nitrobin/OpenBot/body/README.de-DE.md

# OpenBot: Roboterkörper

<p align="center">
  <a href="README.ru-RU.md">Русский</a> |
  <a href="README.md">English</a> |
  <a href="README.zh-CN.md">简体中文</a> |
  <span>Deutsch</span> |
  <a href="README.fr-FR.md">Français</a> |
  <a href="README.es-ES.md">Español</a> |
  <a href="README.ko-KR.md">한국어</a>
</p>

Sie können einen [Ready-to-Run (RTR)](rtr) OpenBot auf Amazon kaufen:
- [RTR-TT](https://buy.openbot.org/rtr-tt)
- [RTR-520](https://buy.openbot.org/rtr-520)

Für größere Bestellungen kontaktieren Sie uns bitte per E-Mail.

## Eigenbau

Sie können einen beliebigen Roboterkörper mit Rädern um einen Mikrocontroller wie den Arduino Nano herum bauen, um ihn mit der OpenBot-Software zu verwenden. Wir haben einen [3D-gedruckten Körper](diy) für einen Roboter mit Rädern entworfen, der auf kostengünstiger, leicht verfügbarer Hobby-Hardware basiert. [OpenBot Lite](lite) ist eine kleinere und vereinfachte Variante der OpenBot DIY-Version, die für Bildungszwecke entwickelt wurde. Selbst wenn Sie ihn nicht bauen möchten, könnten Sie die [Schritt-für-Schritt-Videoanleitungen](lite/#step-by-step-video-guides) hilfreich finden. Wir haben auch einen [3D-gedruckten Körper](rc_truck) für kommerziell erhältliche 1:16 RC-Trucks (wie [diesen](https://www.amazon.de/dp/B00M3J7DJW)) entworfen. Zudem bieten wir Baupläne für ein [Multi-Terrain-Fahrzeug](mtv) an, das als Allzweckplattform für Outdoor-Projekte mit dem OpenBot-Framework dient.

Im Folgenden finden Sie einige Beispiele mit Bauanleitungen und weiteren Details:

<table style="width:100%;border:none;text-align:center">
  <tr>
  <td>  <a href="diy">
    DIY
  </a>
  </td>
  <td>
  <a href="lite">
    Lite
  </a>
  </td>
  <td>
  <a href="rc_truck">
    RC Truck
  </a>
  </td>
  <td>
  <a href="mtv">
    Multi-Terrain Vehicle
  </a>
  </td>
  <td>
  <a href="rtr">
    RTR
  </a>
  </td>
  </tr>
  <tr>
    <td><a href="diy"> DIY </a></td>
    <td><a href="lite"> Lite </a></td>
    <td><a href="rc_truck"> RC Truck </a></td>
    <td><a href="mtv"> Multi-Terrain Vehicle </a></td>
    <td><a href="rtr"> RTR </a></td>
  </tr>
</table>

## Weiter

Flashen Sie die [Arduino-Firmware](../firmware/README.md)
