nitrobin/OpenBot/firmware/README.ru-RU.md

# Прошивка

<p align="center">
  <span>Русский</span> |
  <a href="README.md">English</a> |
  <a href="README.zh-CN.md">简体中文</a> |
  <a href="README.de-DE.md">Deutsch</a> |
  <a href="README.fr-FR.md">Français</a> |
  <a href="README.es-ES.md">Español</a> |
  <a href="README.ko-KR.md">한국어</a>
</p>

Терминология: [глоссарий OpenBot DIY](../GLOSSARY.ru-RU.md).

Микроконтроллер (microcontroller unit, MCU) обеспечивает связь между аппаратной частью робота и смартфоном. Проект содержит [прошивку](openbot/openbot.ino) для Arduino Nano на базе ATmega328P и для отладочных плат ESP32.

## Возможности

Основная задача микроконтроллера — низкоуровневое управление роботом и получение показаний установленных на нём датчиков. По последовательному соединению он принимает команды движения и включения указателей поворота. Команды движения преобразуются в сигналы широтно-импульсной модуляции (ШИМ, PWM) для драйвера двигателей; светодиоды переключаются в соответствии с командами указателей поворота.

Программа также отслеживает вращение колёс, подсчитывая прерывания от оптических датчиков на переднем левом и переднем правом колёсах. Напряжение аккумуляторной батареи вычисляется по измерениям делителя напряжения с фильтрацией скользящим средним и пересчётом масштаба. Дополнительный ультразвуковой дальномер позволяет измерять расстояние до препятствий перед роботом. Результаты измерений передаются в приложение Android по последовательному соединению.

## Выбор аппаратной конфигурации

В начале файла прошивки выберите вариант конструкции робота:

- Самостоятельная сборка с Arduino Nano и драйвером L298N: `OPENBOT DIY`.
- Специализированная печатная плата: `OPENBOT PCB_V1` или `OPENBOT PCB_V2` в зависимости от версии платы.
- Комплект OpenBot с мотор-редукторами TT: `OPENBOT RTR_TT`.
- Переоборудованный радиоуправляемый грузовик: `OPENBOT RC_CAR`.
- Уменьшенный учебный вариант DIY: `OPENBOT LITE`.
- Комплект Ready-to-Run с двигателями серии 520: `OPENBOT RTR_520`.
- Вездеходная платформа Multi-Terrain Vehicle: `OPENBOT MTV`.
- Самостоятельная сборка с ESP32: `OPENBOT DIY_ESP32`.

Например, для варианта DIY на ESP32 строка выбора конфигурации должна выглядеть так:

```cpp
#define OPENBOT DIY_ESP32
```

## Bluetooth

OpenBot может обмениваться данными со смартфоном по Bluetooth. Для этого нужна поддерживаемая плата ESP32, например в конфигурациях `RTR_520`, `MTV` или `DIY_ESP32`.

**Уточнение к исходнику:** английская инструкция указывает `BLUETOOTH 1`, но в [текущей прошивке](openbot/openbot.ino) используется флаг `HAS_BLUETOOTH`. Для включения установите `HAS_BLUETOOTH 1`, для отключения — `HAS_BLUETOOTH 0` в блоке выбранной аппаратной конфигурации.

## Настройка функций

Выберите функции, которые необходимо включить. Отключённые функции не компилируются, что экономит память и ускоряет выполнение программы. Если флаг не определён, функция отключена. Для каждого варианта робота предусмотрены настройки по умолчанию; изменяйте их в соответствии с фактически установленными компонентами.

- Делитель напряжения: `HAS_VOLTAGE_DIVIDER 1` для включения, `0` для отключения. При наличии делителя укажите коэффициент `VOLTAGE_DIVIDER_FACTOR`, рассчитываемый как `(R1+R2)/R2`, минимальное напряжение для привода двигателей `VOLTAGE_MIN`, нижний порог напряжения батареи `VOLTAGE_LOW` и максимальное напряжение батареи `VOLTAGE_MAX`.
- Светодиоды указателей поворота: `HAS_INDICATORS 1`, отключение — `0`.
- Передние и задние датчики частоты вращения: `HAS_SPEED_SENSORS_FRONT 1` и `HAS_SPEED_SENSORS_BACK 1` соответственно, отключение — `0`.
- Ультразвуковой дальномер: `HAS_SONAR 1`, отключение — `0`. Для медианной фильтрации измерений используйте `SONAR_MEDIAN 1`, отключение — `0`.
- Датчик столкновения в бампере: `HAS_BUMPER 1`, отключение — `0`.
- OLED-дисплей: `HAS_OLED 1`, отключение — `0`.
- Передние, задние светодиоды и светодиоды состояния: `HAS_LEDS_FRONT 1`, `HAS_LEDS_BACK 1` и `HAS_LEDS_STATUS 1` соответственно, отключение — `0`.

**Уточнение к исходнику:** для медианного фильтра в английском README указано `USE_MEDIAN`, а в текущем коде используется `SONAR_MEDIAN`.

### Зависимости

Если включены датчики частоты вращения или ультразвуковой дальномер, для Arduino Nano установите библиотеку [PinChangeInterrupt](https://github.com/NicoHood/PinChangeInterrupt). У Nano только два вывода внешних прерываний — `D2` и `D3`, причём `D3` также входит в число шести выводов с поддержкой ШИМ. Кроме того, микроконтроллер имеет три группы прерываний по изменению состояния выводов (pin-change interrupts), охватывающие все выводы Arduino. Библиотека обрабатывает эти групповые прерывания и позволяет использовать отдельные выводы как источники прерываний.

Если включён OLED-дисплей, установите [Adafruit_SSD1306](https://github.com/adafruit/Adafruit_SSD1306) и [Adafruit_GFX Library](https://github.com/adafruit/Adafruit-GFX-Library).

Для установки библиотеки:

1. Откройте менеджер библиотек: `Tools` :arrow_right: `Manage Libraries`.
2. Введите название библиотеки в строку поиска.
3. Выберите последнюю версию и нажмите кнопку установки. Если библиотека уже установлена, менеджер покажет её состояние и доступное обновление.

<p float="left">
  
  
</p>

### Клоны Arduino Nano с преобразователем CH340

Для некоторых клонов Nano может понадобиться драйвер USB–последовательного преобразователя [CH340](http://www.wch.cn/product/CH340.html) с сайта производителя WCH:

- [Windows](http://www.wch.cn/downloads/CH341SER_EXE.html).
- [Linux](http://www.wch.cn/download/CH341SER_LINUX_ZIP.html).
- [macOS](http://www.wch.cn/download/CH341SER_MAC_ZIP.html).

### Отладочная плата ESP32

Чтобы добавить поддержку ESP32 в Arduino IDE:

1. Откройте `File > Preferences`.
   <p align="center">
     Настройки Arduino IDE
   </p>
2. В поле `Additional Board Manager URLs` вставьте `https://dl.espressif.com/dl/package_esp32_index.json` и нажмите `OK`.
   <p align="center">
     Добавление адреса пакета плат ESP32
   </p>

   **Примечание:** если уже добавлен адрес пакета ESP8266, разделите адреса запятой:

   ```text
   https://dl.espressif.com/dl/package_esp32_index.json,
   http://arduino.esp8266.com/stable/package_esp8266com_index.json
   ```

3. Откройте менеджер плат: `Tools > Board > Boards Manager`.
   <p align="center">
     Открытие менеджера плат
   </p>
4. Найдите пакет `ESP32 by Espressif Systems`, выберите версию **2.0.17** и нажмите кнопку установки. Согласно исходной инструкции, версии **3.x.x несовместимы с этой прошивкой**.
   <p align="center">
     Установка пакета ESP32
   </p>
5. После установки пакета Arduino IDE готова к загрузке прошивки в ESP32 вашего OpenBot.
   <p align="center">
     Установленная поддержка ESP32
   </p>
6. Выберите плату `ESP32 Dev Module` в меню `Tools > Board > ESP32 Arduino`. Дополнительные пояснения и способы устранения проблем при загрузке прошивки приведены в [инструкции, на которую ссылается исходный README](https://randomnerdtutorials.com/installing-the-esp32-board-in-arduino-ide-windows-instructions/).
   <p align="center">
     Выбор платы ESP32 Dev Module
   </p>

Если загрузка не проходит, попробуйте снизить скорость передачи (baud rate): в меню `Tools` установите `Upload Speed` в значение `115200` бод.

<p align="center">
  Выбор скорости загрузки прошивки
</p>

## Загрузка прошивки

### Настройки Arduino Nano

- `Tools` :arrow_right: `Board` :arrow_right: `Arduino AVR Boards` :arrow_right: `Arduino Nano`.
- `Tools` :arrow_right: `Processor` :arrow_right: `ATmega328P (Old Bootloader)`.
- `Tools` :arrow_right: `Port` :arrow_right: выберите USB-порт подключённой платы.

:memo: **Примечание:** в исходной инструкции отмечено, что недорогие платы Nano часто используют старый загрузчик (`Old Bootloader`), но встречаются и платы с новым. Если загрузка не удаётся, попробуйте изменить выбор процессора на `ATmega328P`.

### Настройки ESP32

- `Tools` :arrow_right: `Board` :arrow_right: `ESP32 Arduino` :arrow_right: `ESP32 Dev Module`.
- `Tools` :arrow_right: `Port` :arrow_right: выберите USB-порт подключённой платы.

### Запись программы в микроконтроллер

Загрузите прошивку через `Sketch` :arrow_right: `Upload` или нажмите кнопку загрузки со стрелкой вправо.

Загрузка прошивки

### Проверка

После успешной загрузки прошивки проверьте функции робота.

1. Убедитесь, что:
   1. Колёса сняты с робота.
   2. Arduino подключена к компьютеру.
   3. Выбран правильный USB-порт.
2. Откройте монитор последовательного порта: `Tools` :arrow_right: `Serial Monitor`.

#### Отправка команд OpenBot

Введите команду в верхнее поле монитора последовательного порта и нажмите кнопку отправки. Доступны следующие команды, если робот поддерживает соответствующие функции:

- `c<left>,<right>` — управление левой и правой сторонами привода. Значения `<left>` и `<right>` находятся в диапазоне [-255, 255]. `0` останавливает двигатели, `255` задаёт максимальное управление для движения вперёд. Меньшие положительные значения уменьшают коэффициент заполнения ШИМ и скорость; отрицательные изменяют полярность управления и задают движение назад.
- `i<left>,<right>` — управление левым и правым указателями поворота. Значения находятся в диапазоне [0, 1]. `i1,0` включает левый указатель, `i0,1` — правый, `i1,1` — оба. Включённые указатели мигают один раз в секунду. `i0,0` выключает их. Одновременно действует одно заданное состояние.
- `l<front>,<back>` — яркость передних и задних светодиодов. Значения `<front>` и `<back>` находятся в диапазоне [0, 255].
- `s<time_ms>` — интервал между запусками измерения ультразвукового дальномера в миллисекундах; значение по умолчанию — 1000. После измерения передаётся результат. Если истёк срок ожидания эхо-сигнала, передаётся значение `MAX_SONAR_DISTANCE`.
- `w<time_ms>` — интервал передачи данных колёсной одометрии в миллисекундах; по умолчанию — 1000. Вращение колёс отслеживается непрерывно, а частота вращения в об/мин вычисляется как среднее за заданный интервал.
- `v<time_ms>` — интервал передачи измерений напряжения в миллисекундах; по умолчанию — 1000. Напряжение измеряется непрерывно и фильтруется скользящим средним по 10 отсчётам. Команда также вызывает передачу минимального напряжения для привода двигателей (`vmin:<value>`), нижнего порога напряжения батареи (`vlow:<value>`) и максимального напряжения батареи (`vmax:<value>`).
- `h<time_ms>` — время в миллисекундах, после которого робот остановится, если не получено новое сообщение контроля активности (heartbeat); по умолчанию — -1.
- `b<time_ms>` — время в миллисекундах до сброса события срабатывания датчика столкновения; по умолчанию — 750.
- `n<color>,<state>` — управление светодиодом состояния. `<color>` задаёт цвет: `b` — синий, `g` — зелёный, `y` — жёлтый. `<state>` задаёт состояние: `0` — выключен, `1` — включён.
- `f` — запрос типа робота и поддерживаемых функций: измерение напряжения (`v`), указатели поворота (`i`), ультразвуковой дальномер (`s`), датчики столкновения (`b`), колёсная одометрия (`wf`, `wb`), светодиоды (`lf`, `lb`, `ls`) и другие. Пример сообщения для указанного в исходнике варианта `RTR_V1`: `fRTR_V1:v:i:s:b:wf:wb:lf:lb:ls:`.

#### Получение сообщений от OpenBot

Набор сообщений зависит от аппаратной конфигурации.

Монитор последовательного порта

- Сообщения с префиксом `v` содержат напряжение аккумуляторной батареи. При подключённой батарее и включённом питании должно отображаться её напряжение. При отключённой батарее или выключенном питании значение должно быть небольшим.
- Сообщения с префиксом `w` содержат показания датчиков частоты вращения в **об/мин (rpm)**. Каждая прорезь диска энкодера изменяет счётчик на +1 или −1 в зависимости от направления вращения. Для стандартного диска с 20 прорезями приходится 20 отсчётов на оборот колеса.
- Сообщения с префиксом `s` содержат оценку расстояния до препятствия перед ультразвуковым дальномером в сантиметрах.
- Сообщения с префиксом `b` сообщают о столкновениях. Коды `lf` (спереди слева), `rf` (спереди справа), `cf` (спереди по центру), `lb` (сзади слева), `rb` (сзади справа) указывают на сработавший датчик.

**Уточнения к исходнику:** в английском README единицы `rpm` ошибочно названы оборотами в секунду. В функции `send_wheel_reading()` [прошивки](openbot/openbot.ino) используется пересчёт в обороты в минуту. Число импульсов на оборот в текущем коде задаётся параметром `TICKS_PER_REV`, а не упомянутым в английской инструкции `DISK_HOLES`.

#### Порядок проверки

Перед проверкой убедитесь, что колёса сняты. Откройте монитор последовательного порта для отправки команд и просмотра ответов OpenBot. При наличии OLED-дисплея состояние робота также отображается на нём в удобном для чтения виде.

1. Включите питание робота и проверьте напряжение батареи — число после `v`. Сравните показание с измерением мультиметром и при необходимости скорректируйте `VOLTAGE_DIVIDER_FACTOR`.
2. Если установлен ультразвуковой дальномер:
   1. Поднесите руку перед датчиком и перемещайте её ближе и дальше. Показание после `s` должно изменяться соответственно.
   2. По наблюдениям разработчиков, ультразвуковой датчик чувствителен к вибрациям. Для проверки устойчивости показаний во время работы:
      1. Разместите робот так, чтобы перед датчиком было не менее 200 см свободного пространства. Показание должно быть `200` или больше.
      2. Некоторое время наблюдайте за показаниями, затем отправьте `c128,128`.
      3. Если показания существенно изменились, уменьшите передачу вибраций от шасси к датчику, например добавьте силиконовый демпфирующий элемент или измените место крепления.
3. Если установлены датчики частоты вращения:
   1. Обеспечьте достаточно свободного пространства перед ультразвуковым дальномером. Показание после `s` должно превышать `STOP_DISTANCE`; по умолчанию это 10 см.
   2. Отправьте `c128,128`. Двигатели начнут вращаться с уменьшенным управлением — коэффициент заполнения ШИМ около 50 %. Для `RTR_TT` исходная инструкция приводит показания 250–300 об/мин в зависимости от степени заряженности батареи (state of charge, SOC). Для DIY или менее мощной батареи значения могут быть ниже. Убедитесь, что все двигатели вращаются вперёд и показания датчиков положительны.
   3. Попробуйте другие команды. `c-128,-128` задаёт вращение всех двигателей назад с заполнением ШИМ около 50 %. `c255,-255` задаёт вращение левых двигателей вперёд, а правых назад с заполнением 100 %. `c-192,192` задаёт вращение левых двигателей назад, а правых вперёд с заполнением около 75 %.
4. Остановите двигатели командой `c0,0` или, при установленном и включённом ультразвуковом дальномере, поднесите руку перед ним.
5. Если установлены указатели поворота, отправьте `i1,0` и проверьте мигание левого светодиода, затем `i0,1` — правого. Для выключения отправьте `i0,0`.

### Режим без смартфона

До проверки с приложением OpenBot можно проверить робот без смартфона. Установите `NO_PHONE_MODE` в `1`. Робот будет двигаться с обычным для этого режима управлением — коэффициентом заполнения ШИМ около 75 % — и замедляться при обнаружении препятствий ультразвуковым дальномером. При приближении к порогу поворота он начнёт поворачивать в случайную сторону и включит указатель поворота с этой стороны. Если расстояние станет меньше порога, робот будет медленно двигаться назад с включёнными обоими указателями.

**Уточнение к исходнику:** порог поворота в текущей прошивке называется `TURN_DISTANCE` и по умолчанию равен 50 см; в английском README использовано устаревшее имя `TURN_THRESHOLD`.

Питание требуется как силовой части робота, так и Arduino. Arduino можно питать от выхода `5V` драйвера L298N, подключив его к выводу `5V` платы, либо через USB от источника питания, например смартфона.

Перед запуском разработчики рекомендуют снять колёса, подключить Arduino к компьютеру и наблюдать за монитором последовательного порта, как описано в разделе [«Проверка»](#проверка). В этом режиме вывод удобнее для чтения и, как OLED-дисплей, показывает напряжение батареи, частоту вращения левых и правых двигателей и расстояние до препятствия впереди. Перемещайте крупный предмет перед датчиком и наблюдайте за изменением частоты вращения двигателей.

:warning: **Предупреждение из исходной инструкции:** если ультразвуковой дальномер отсутствует или отключён, робот будет непрерывно двигаться вперёд с заполнением ШИМ около 75 % и в итоге столкнётся с препятствием. Даже при установленном датчике столкновения возможны из-за помех в измерениях.

## Требования к другим микроконтроллерам

Можно использовать другой микроконтроллер, обеспечив следующие интерфейсы:

- 1 × преобразователь USB–TTL для последовательной связи со смартфоном.
- 4 × выхода ШИМ для управления двигателями.
- 1 × аналоговый вход для контроля напряжения батареи.
- 2 × цифровых вывода для датчиков частоты вращения.
- 1 × цифровой вывод для ультразвукового дальномера, если он установлен.
- 2 × цифровых вывода для светодиодов указателей поворота, если они установлены.

**Уточнение к исходнику:** в общем перечне выше сохранено исходное требование одного цифрового вывода для дальномера. Однако схема OpenBot DIY с Arduino Nano использует два отдельных вывода — `Trigger` и `Echo`; это видно в [инструкции по сборке](../body/diy/README.ru-RU.md) и в настройках `PIN_TRIGGER` / `PIN_ECHO` [прошивки](openbot/openbot.ino).

## Следующий шаг

Соберите и запустите [приложения для Android](../android/README.ru-RU.md).
