nitrobin/OpenBot/body/diy/README.md

# OpenBot DIY

<p align="center">
  <a href="README.ru-RU.md">Русский</a> |
  <span>English</span> |
  <a href="README.zh-CN.md">简体中文</a> |
  <a href="README.de-DE.md">Deutsch</a> |
  <a href="README.fr-FR.md">Français</a> |
  <a href="README.es-ES.md">Español</a> |
  <a href="README.ko-KR.md">한국어</a>
</p>

We have designed a body for a wheeled robot which relies on low-cost, readily available hobby hardware. You can find instructions for building you own robot below. If you have any further questions or concerns, please feel free to contact us. Happy robot building!

## Chassis

### 3D printing

You will need to print and assemble the following parts in order to build your OpenBot.

#### Robot body

There are several options for the robot body depending on your needs and capabilities of your 3D printer. We encourage you to design and build your own, but here are some options as starting point: 

- [Regular body](cad/regular_body/README.md): This is the standard body we designed; it requires a build plate with least 240mmx150mm.
- [Slim body](cad/slim_body/README.md): Since a lot of common 3D printers have a smaller build volume, we have also designed a smaller version without bumpers which fits on a 220mmx220mm build plate at 45 degrees.
- [Glueable body](cad/glue_body/README.md): For printing on 3D printers with even smaller build volumes, there is also a modular body designed by @sloretz with serveral parts that need to be glued together; it fits on a 150mmx140mm build plate.
- [Blocky body](cad/block_body/README.md): This body designed by @Christos-Ps provides multiple variants with options for extra space inside the shell and a lego-compatible top while maintaining a small footprint that requires only 221mmx150mm for printing.

#### Phone mount

In addition, you will need to print a phone mount to be fixed to robot body.

- phone_mount_bottom ([STL](../phone_mount/phone_mount_bottom.stl), [STEP](../phone_mount/phone_mount_bottom.step))
- phone_mount_top ([STL](../phone_mount/phone_mount_top.stl), [STEP](../phone_mount/phone_mount_top.step))

#### Cleaning

Before you proceed with the build, you may need to clean the 3D print.
<p float="left">
  
   
  
</p>

### Alternatives

If you do not have access to a 3D printer, there are several Arduino robot car kits available which you can use as a starting point. These kits come with a chassis, motors and accessories. We recommend to get a basic kit, since you won't need a lot of the electronics and sensors of the more expensive kits. Here are some options:

- Perseids DIY Robot Smart Car Chassis Kit ([EU](https://www.amazon.de/dp/B07DNXBNHY), [US](https://www.amazon.com/dp/B07DNXBFQN))
- SZDoit 4WD Smart Metal Robot Car Chassis Kit ([US](https://www.amazon.com/dp/B083K4RKBP), [AE](https://www.aliexpress.com/item/33048227237.html))
- Joy-it Robot Car Kit 01 ([EU](https://www.amazon.de/dp/B073ZGJF28))
- Smart Car Kit 4WD Smart Robot Car Chassis Kit ([AE](https://www.aliexpress.com/item/4001238626191.html))

You will also need a phone mount. Here are some options:

- Phone Mount ([EU](https://www.amazon.de/dp/B06XDYJNSR), [US](https://www.amazon.com/dp/B09CY8MC2R))

You can also get creative and build your own OpenBot chassis and phone mount using a material of your choice (e.g. wood, cardboard, styrofoam, etc.). If you do, please post some pictures on the [Slack channel](https://github.com/ob-f/OpenBot#contact) so others can admire your creativity. Here is one example by [@custom-build-robots](https://custom-build-robots.com/roboter/openbot-dein-smartphone-steuert-ein-roboter-auto-chassis-bauen/13636):

<p float="left">
  
  
  
</p>

## Assembly

There are two different options for assembly of the robot, DIY and PCB. The DIY approach relies on the popular L298N motor driver and is recommended for hobbyists with some electronics experience. It requires a fair amount of wiring, especially if all the sensors and LEDs are installed. However, all components are readily available in most contries and especially for single builds or just to try out the project, the DIY option is recommended. In order to reduce the wiring and make assembly easier, we have also developed a [custom PCB](pcb). This is recommended if you desire a cleaner build or want to build multiple OpenBots.

### Bill of materials

Our robot body relies on readily available hobby electronics. We provide links for Germany (EU) and the United States (US) with fast shipping. If you have the patience to wait a bit longer, you can also get the components a lot cheaper from AliExpress (AE). You will need the following components.

#### Required components

- 1x Arduino Nano ([EU](https://www.amazon.de/dp/B01MS7DUEM), [US](https://www.amazon.com/dp/B00NLAMS9C), [AE](https://www.aliexpress.com/item/32866959979.html))
- 4x TT motors with tires ([EU](https://www.conrad.de/de/p/joy-it-com-motor01-getriebemotor-gelb-schwarz-passend-fuer-einplatinen-computer-arduino-banana-pi-cubieboard-raspbe-1573543.html), [US](https://www.amazon.com/dp/B081YQM55P), [AE](https://www.aliexpress.com/item/4000126948489.html))
- 3x 18650 battery ([EU](https://www.conrad.de/de/p/conrad-energy-18650-usb-spezial-akku-18650-li-ion-3-7-v-1400-mah-1525536.html), [US](https://www.amazon.com/dp/B083K4XSKG), [AE](https://www.aliexpress.com/item/32352434845.html))
- 1x 18650 battery holder([EU](https://www.amazon.de/dp/B075V25QJ9), [US](https://www.amazon.com/dp/B07DWQYD7H), [AE](https://www.aliexpress.com/item/33037738446.html))
- 1x USB OTG cable ([EU](https://www.amazon.de/gp/product/B075M4CQHZ) ,[US](https://www.amazon.com/dp/B07LBHKTMM), [AE](https://www.aliexpress.com/item/10000330515850.html))
- 1x spring or rubber band ([EU](https://www.amazon.de/gp/product/B01N30EAZO/), [US](https://www.amazon.com/dp/B008RFVWU2), [AE](https://www.aliexpress.com/item/33043769059.html))
- 16x M3x25 screw ([EU](https://www.amazon.de/dp/B07KFL3SSV), [US](https://www.amazon.com/dp/B07WJL3P3X), [AE](https://www.aliexpress.com/item/4000173341865.html))
- 16x M3 nut ([EU](https://www.amazon.de/dp/B07JMF3KMD), [US](https://www.amazon.com/dp/B071NLDW56), [AE](https://www.aliexpress.com/item/32977174437.html))
- 6x M3x5 screw ([EU](https://www.amazon.de/dp/B01HBRG3W8), [US](https://www.amazon.com/dp/B07MBHMLL2), [AE](https://www.aliexpress.com/item/32892594230.html))
- Dupont cables ([EU](https://www.amazon.de/dp/B07KYHBVR7), [US](https://www.amazon.com/dp/B07GD2BWPY), [AE](https://www.aliexpress.com/item/4000766001685.html))

#### Optional components

- 2 x Speed Sensor ([EU](https://www.conrad.de/de/p/joy-it-sen-speed-erweiterungsmodul-passend-fuer-einplatinen-computer-arduino-banana-pi-cubieboard-raspberry-pi-pc-1646891.html), [US](https://www.amazon.com/dp/B081W2TY6Q), [AE](https://www.aliexpress.com/i/32850602744.html))
- 1x Ultrasonic Sensor ([EU](https://www.amazon.de/dp/B00LSJWRXU), [US](https://www.amazon.com/dp/B0852V181G/), [AE](https://www.aliexpress.com/item/32713522570.html))
- 1x On/Off Switch ([EU](https://www.amazon.de/dp/B07QB22J62), [US](https://www.amazon.com/dp/B01N2U8PK0), [AE](https://www.aliexpress.com/item/1000005699023.html))
- 2x Orange LED 5mm ([EU](https://www.amazon.de/gp/product/B01NCL0UTQ), [US](https://www.amazon.com/dp/B077XD7MVB), [AE](https://www.aliexpress.com/item/4000329069943.html))
- 1x OLED display ([EU](https://www.amazon.de/dp/B079H2C7WH), [US](https://www.amazon.com/dp/B085NHM5TC), [AE](https://www.aliexpress.com/item/4001268387467.html))

#### DIY components (Option 1)

- 1x L298N Motor Driver ([EU](https://www.conrad.de/de/p/joy-it-motormodul-2-u-4-phasen-6-bis-12v-1573541.html), [US](https://www.amazon.com/dp/B085XSLKFQ), [AE](https://www.aliexpress.com/item/32994608743.html))
- (Optional) Resistors (2x 150<span>&#8486;</span> for the LEDs and a 20 k<span>&#8486;</span> and 10k<span>&#8486;</span> for the voltage divider)
- (Combo) 4x TT motors & tires + 2x L298N + dupont cables ([US](https://www.amazon.com/dp/B07ZT619TD))
- (Combo) 4x TT motors & tires + wires + screws ([US](https://www.amazon.com/dp/B07DRGTCTP))

#### PCB components (Option 2)

- 1x [Custom PCB](pcb)
- 5x Micro JST PH 2.0 cable ([EU](https://www.amazon.de/gp/product/B07449V33P), [US](https://www.amazon.com/dp/B09JZC28DP), [AE](https://www.aliexpress.com/item/32963304134.html))

### Build instructions

**Tip:** Click on the images to open them in full resolution in a new tab.

#### Option 1: DIY

<p float="left">
  
   
</p>

**Tip:** To make all the wiring easier you can build a small power distributor for the 5V and GND connections by soldering a 6x2 male header to a perfboard. Then connect the power distributor with the 5V / GND of the motor driver.

1. Solder wires to the motors and add the encoder disks to the two front motors if you intend to use the speed sensors.
    <p float="left">
      
       
    </p>
2. Insert the positive and negative leads of the two left motors into OUT1 (+) and OUT2 (-) of the L298N board. Insert the positive and negative leads of the two right motors into OUT4 (+) and OUT3 (-) of the L298N board.
3. Mount the motors with eight M3x25 screws and nuts.
    <p float="left">
      
       
      
    </p>
4. Mount the L298N with four M3x5 screws
5. (Optional) Install the ultrasonic sensor and replace the angled connector with a straigt one (or carefully bend the pins).
    <p float="left">
      
       
      
    </p>
6. (Optional) Install the orange LEDs for the indicator signals.
    <p float="left">
      
       
      
    </p>
7. Mount the bottom of the phone mount to the top plate using two M3x25 screws and nuts.
    <p float="left">
      
       
      
    </p>
8. Insert the top of the phone mount and install the spring or rubber band.
    <p float="left">
      
       
    </p>
9. Replace the angled connector with a straigt one (or carefully bend the pins) and then mount the speed sensors with one M3x5 screw each.
    <p float="left">
      
       
      
    </p>
10. Install the battery case (e.g. velcro).
    <p float="left">
      
       
      
    </p>
11. (Optional) Insert the on/off switch put it in the current path.
    1. Push the switch into the appropriate opening until you hear a click.
    2. Solder the red wires (12V) of the battery case and the power cable each to one of the pins of the switch. Connect the black wires (GND), and cover the connection with some heatshrink.
    3. Fix the cables with some tape.
    <p float="left">
      
       
      
    </p>
12. (Optional) Attach the OLED display.
13. Connect the PWM inputs of the L298N to pins D5, D6, D9 and D10 of the Arduino.
14. Connect the speed sensors and ultrasonic sensor to 5V and GND.
15. Connect pin D0 of the speed sensors to pins D2 (left) and D3 (right) of the Arduino.
16. Connect pins Echo and Trigger of the ultrasonic sensor to pins D11 and D12 of the Arduino respectively.
17. (Optional) Connect the LEDs to pins D4 (left) and D7 (right) of the Arduino and GND. We recommend to add a 150 Ohm resistor in series to limit the current draw.
18. (Optional) Connect the voltage divider to pin A7 of the Arduino. It is used to measure the battery voltage.
19. (Optional) Connect the OLED display (SSD1306 chip) via the I2C bus to the Arduino Nano
    1. Connect the VIN and GND pins of the display to 5V and GND.
    2. Connect the SCL pin of the display to the A5 pin.
    3. Connect the SDA pin of the display to the A4 pin.
20. Connect the power cables to +12V and GND of the L298N.
21. Connect the USB cable to the Arduino and route it through the top cover.
22. Insert six M3 nuts into the bottom plate and mount the top cover with six M3x25 screws.
23. Install the wheels.

#### Option 2: Custom PCB

1. Solder wires with Micro JST PH 2.0 connectors to the motors and add the encoder disks to the two front motors if you intend to use the speed sensors.
    <p float="left">
      
       
    </p>
2. Mount the motors with eight M3x25 screws and nuts.
    <p float="left">
      
       
      
    </p>
3. Connect the left two motors to M3 and M4 and the right two motors to M1 and M2.
    <p float="left">
      
    </p>
4. Mount the PCB with four M3x5 screws and the motors with eight M3x25 screws and nuts.
    <p float="left">
      
      
    </p>
5. Follow steps 5-12 from the DIY option.
6. Connect the ultrasonic sensor (VCC/+, Trig, Echo, GND/-) to the 4-pin header labeled *SONAR* on the PCB.
    <p float="left">
      
    </p>
7. Connect the left and right indicator signals (orange LEDs) to the 2-pin headers labeled *SIGNAL_L* and *SIGNAL_R* on the PCB. The longer leg is + and the shorter one -.
8. Connect the left and right speed sensors (VCC/+, GND/-, D0) to the 3-pin headers labeled *SPEED_L* and *SPEED_R*.
9. (Optional) Connect the OLED display (SSD1306 chip) to the IO2 header on the PCB.
    1. Connect the VIN and GND pins of the display to 5V and GND.
    2. Connect the SCL pin of the display to the A5 pin.
    3. Connect the SDA pin of the display to the A4 pin.
10. Connect the power cables to Vin (Micro JST PH 2.0 connector) of the PCB.
11. Follow steps 21-23 from the DIY option.

## Next

Flash the [Arduino Firmware](../../firmware/README.md)
