nitrobin/OpenBot/body/diy/fritzing/README.ru-RU.md

# Схема OpenBot DIY для Arduino Nano в Fritzing

Открой [openbot-diy-nano.fzz](openbot-diy-nano.fzz) в Fritzing и выбери вкладку **Schematic**. В файле находятся отдельные редактируемые компоненты, контакты и провода. Все необходимые определения компонентов и SVG включены в `.fzz`; скачивать библиотеку модулей отдельно не требуется.

Для вида с изображениями плат открой [отдельный файл Breadboard для Nano](openbot-diy-nano-breadboard.fzz). [Превью и пояснения](README.breadboard.ru-RU.md) показывают расположение контактов, USB-разъёма и клемм.

[Новая схема отдельного распределителя питания](README.power-hub.ru-RU.md) позволяет подключать батарейный блок и выключатель съёмными двухконтактными разъёмами.

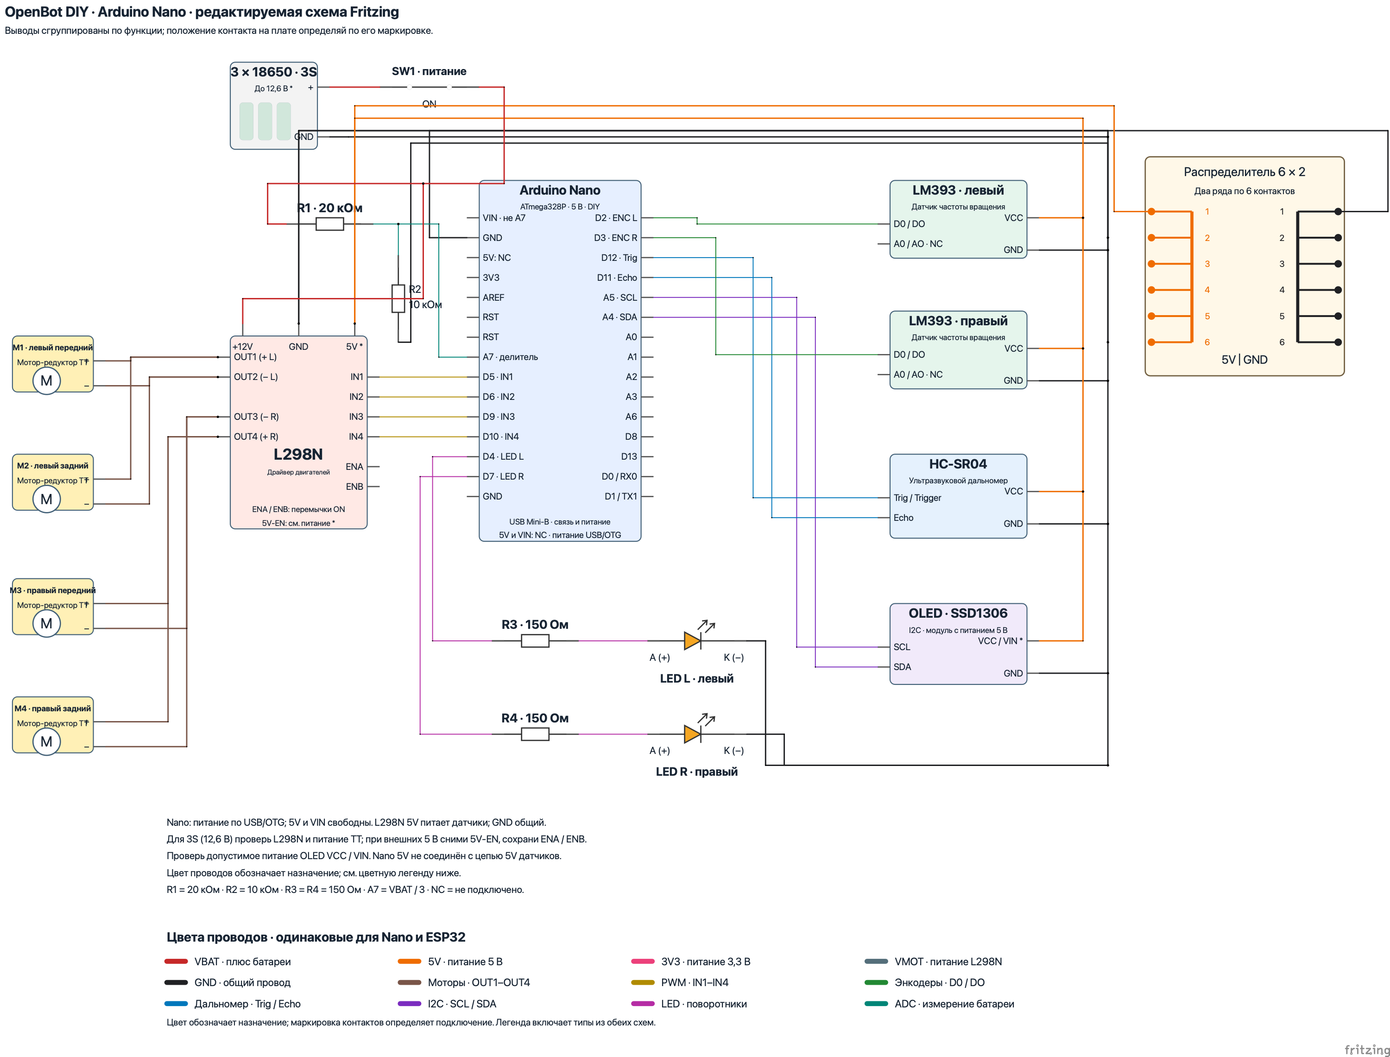
[picture p1: body/diy/fritzing/openbot-diy-nano.png]
Схема OpenBot DIY для Arduino Nano с подписями контактов и номиналами резисторов


Превью PNG экспортировано из Fritzing 1.0.8. На картинку можно нажать, чтобы рассмотреть подписи в полном размере.

Цвета проводов различаются по назначению и совпадают со схемой ESP32. Внизу рисунка есть цветная легенда; [таблица цветов](WIRE-COLORS.ru-RU.md) поясняет все типы цепей.

Схема перерисована по [исходному изображению](../../../docs/images/wiring_diagram.png), [инструкции DIY](../README.ru-RU.md) и блоку `OPENBOT == DIY` в [прошивке](../../../firmware/openbot/openbot.ino). Подписаны оба конца соединений, полярность светодиодов и номиналы резисторов. Положение выводов сгруппировано по функции, чтобы провода можно было проследить. При монтаже находи контакт на своей плате **по маркировке**, а не по его положению в этом рисунке. Во вкладке Breadboard используется тот же порядок выводов. Посадочные места и разводка PCB в этом файле не предусмотрены.

| Arduino Nano | Другой конец соединения |
| --- | --- |
| `D5` | L298N `IN1` |
| `D6` | L298N `IN2` |
| `D9` | L298N `IN3` |
| `D10` | L298N `IN4` |
| `D2` | Левый датчик частоты вращения LM393 `D0` / `DO` |
| `D3` | Правый датчик частоты вращения LM393 `D0` / `DO` |
| `D12` | Ультразвуковой дальномер HC-SR04 `Trig` / `Trigger` |
| `D11` | Ультразвуковой дальномер HC-SR04 `Echo` |
| `A5` | OLED-дисплей SSD1306 `SCL` |
| `A4` | OLED-дисплей SSD1306 `SDA` |
| `D4` | R3 **150 Ом** → анод `A` левого светодиода; катод `K` → `GND` |
| `D7` | R4 **150 Ом** → анод `A` правого светодиода; катод `K` → `GND` |
| `A7` | Средняя точка делителя R1 **20 кОм** / R2 **10 кОм** |
| `5V` | Свободен (`NC`); Arduino Nano получает питание через USB |
| `VIN` | Свободен (`NC`) |
| `GND` | Общий провод (`GND`) всех плат и минус аккумуляторной батареи |

R1 включён между плюсом батареи **после SW1** и `A7`. R2 включён между `A7` и `GND`. Это измерительная цепь: `A7 = VBAT / 3`, то есть 4,2 В при напряжении батареи 12,6 В. Контакт питания Nano `VIN` оставлен свободным; он не является входом этого делителя.

**Питание Arduino Nano:** телефон → USB OTG → USB Mini-B Nano. USB обеспечивает питание и последовательную связь; при проверке от ПК Nano также получает питание через USB. Возможность питания Nano от USB описана в [документации Arduino](https://docs.arduino.cc/resources/datasheets/A000005-datasheet.pdf); USB предусмотрен в шаге 21 [инструкции OpenBot DIY](../README.md#option-1-diy). `A7` — аналоговый вход измерения напряжения, питание через него не подаётся. Контакты `5V` и `VIN` Nano внешними проводами не подключены. `GND` Nano соединён с `GND` L298N и датчиков. Обозначение `NC` у `5V` означает отсутствие внешнего провода; при питании по USB на внутренней шине Nano всё равно есть питание.

Два левых мотор-редуктора подключены параллельно: положительные провода к L298N `OUT1`, отрицательные к `OUT2`. Два правых подключены параллельно: положительные к `OUT4`, отрицательные к `OUT3`, как в инструкции DIY. `A0` / `AO` датчиков частоты вращения не подключены. Если у твоего датчика только три контакта, используй `VCC`, `GND` и `D0` / `DO`.

## Технические уточнения

Назначение контактов управления взято из блока `DIY` прошивки: `PIN_PWM_L1=5`, `PIN_PWM_L2=6`, `PIN_PWM_R1=9`, `PIN_PWM_R2=10`, `PIN_LED_LI=4`, `PIN_LED_RI=7`. На новой схеме показаны четыре линии `IN1`–`IN4`; `ENA` и `ENB` имеют установленные перемычки. Они отличаются от перемычки регулятора питания **5V-EN**.

Цепь питания `5V` исходного изображения соединяет L298N, датчики и OLED-дисплей; `5V` Nano к этой цепи не подключён. Это не подтверждает пригодность встроенного регулятора конкретной платы L298N для полностью заряженной батареи 3S (12,6 В) или пригодность твоих мотор-редукторов TT для такого питания. Для внешнего стабилизированного источника 5 В на стандартном модуле L298N следует отключить **5V-EN**, оставив перемычки **ENA/ENB**. Перед монтажом проверь документацию своей платы. Контакт `5V` Nano оставлен свободным и при таком питании датчиков.

**Исправление перерисовки:** в ранних файлах Fritzing был ошибочно добавлен провод между `5V` Nano и цепью `5V` L298N/датчиков. Этот провод удалён из обоих вариантов Nano и обоих видов, согласно [исходной картинке](../../../docs/images/wiring_diagram.png). Все остальные соединения сохранены.

В исходной текстовой инструкции питание OLED названо `VIN`, а на изображении — `VCC`. На новой схеме показаны оба варианта маркировки; подключение к 5 В допустимо только для OLED-модуля, рассчитанного на 5 В. Это не означает, что `VIN` и `VCC` взаимозаменяемы на любой плате.

В текущей прошивке `DIY` дополнительные функции изначально выключены: `HAS_VOLTAGE_DIVIDER`, `HAS_INDICATORS`, `HAS_SONAR`, `HAS_SPEED_SENSORS_FRONT`, `HAS_OLED` равны `0`. После установки нужных компонентов включи соответствующие функции и загрузи обновлённую прошивку. Сам файл Fritzing прошивку не меняет.

## Файлы и проверка

[openbot-diy-nano.fzz](openbot-diy-nano.fzz) — переносимый файл для открытия и редактирования в Fritzing. Все определения компонентов и их графика находятся внутри этого файла. Сохраняй правки непосредственно в `.fzz`.

[validate_topology.py](validate_topology.py) сравнивает соединения четырёх схем с коммитом `12c12e5`, включая свободные контакты, номиналы и внутренние шины. Для Nano эталон содержит явное исправление ранней перерисовки: `5V` Nano должен быть свободен, а общий `GND` сохранён. Остальные цепи сравниваются без изменений. [Отчёт проверки](topology-validation.json) содержит это исправление, результат и контрольные суммы файлов.

Для проверки из корня репозитория:

```sh
python3 body/diy/fritzing/validate_topology.py
```

Проверка читает `.fzz` и обновляет отчёт. Для сравнения нужна история Git с коммитом `12c12e5`.

Created with [Fritzing](https://fritzing.org/). Принципиальная схема и её собственная графика распространяются по [CC BY-SA 3.0](https://creativecommons.org/licenses/by-sa/3.0/); основаны на документации OpenBot. Скрипт проверки распространяется на условиях лицензии OpenBot, указанной в корне репозитория.

Распределитель питания 6 × 2 добавлен согласно инструкции DIY; его ряды `5V` и `GND` изолированы друг от друга. [Пояснения к колодке и источники графики Breadboard](README.breadboard.ru-RU.md).
