nitrobin/OpenBot/body/diy/pcb/README.ru-RU.md

# Специализированная печатная плата

<p align="center">
  <span>Русский</span> |
  <a href="README.md">English</a> |
  <a href="README.zh-CN.md">简体中文</a> |
  <a href="README.de-DE.md">Deutsch</a> |
  <a href="README.fr-FR.md">Français</a> |
  <a href="README.es-ES.md">Español</a> |
  <a href="README.ko-KR.md">한국어</a>
</p>

Терминология: [глоссарий OpenBot DIY](../../../GLOSSARY.ru-RU.md).

Специализированная печатная плата (custom PCB) служит платой-носителем (carrier board) для Arduino Nano. На ней размещены современные драйверы двигателей, делитель напряжения и резисторы светодиодов. Arduino устанавливается в контактную колодку, а датчики и светодиоды подключаются проводами Dupont к соответствующим разъёмам.

Вид печатной платы версии 2 сверху
Трёхмерный вид печатной платы версии 2

Последняя представленная здесь плата — [версия 2](v2). По сравнению с [версией 1](v1) внесены следующие изменения:

- Правый датчик частоты вращения подключён к выводу `D3`, чтобы использовать внешнее прерывание.
- Добавлен светодиод индикации питания от основной аккумуляторной батареи.
- Некоторые компоненты заменены более доступными аналогами.
- Номиналы резисторов делителя напряжения изменены на 20 кОм / 10 кОм для повышения точности.
- Разъёмы двигателей заменены прямыми, с вертикальным расположением контактов, для более удобного доступа.

Если вы уже заказали [версию 1](v1) платы ([вид сверху](../../../docs/images/pcb_2d_v1.png), [трёхмерный вид](../../../docs/images/pcb_3d_v1.png)), она также будет работать. Укажите правильный вариант платы в настройках прошивки.

Изготовление и монтаж специализированной платы состоят из следующих этапов:

1. **Заказ печатной платы.** Скачайте [файлы Gerber](v2/gerber_v2.zip) и закажите изготовление у выбранного производителя. Можно заказать плату непосредственно на [PCBWay](https://www.pcbway.com/project/shareproject/OpenBot__Turning_Smartphones_into_Robots.html), где опубликован проект OpenBot.
2. **Заказ компонентов.** Скачайте [перечень компонентов (BOM)](v2/BOM_v2.csv) и закупите их у выбранного поставщика, например [LCSC](https://lcsc.com).
3. **Монтаж компонентов на плату.** Выполните монтаж самостоятельно или закажите его у производителя. Для автоматического монтажа потребуется [файл координат установки компонентов (centroid file)](v2/centroid_file_v2.csv). При заказе на [JLCPCB](https://jlcpcb.com/) можно воспользоваться услугой поверхностного монтажа (SMT). Тогда самостоятельно понадобится приобрести и припаять только выводные компоненты, устанавливаемые в отверстия платы (through-hole components). По опыту разработчиков, это был наиболее удобный, дешёвый и быстрый вариант. В [версии 2](v2) состав компонентов обновлён с расчётом на их доступность непосредственно у [JLCPCB](https://jlcpcb.com/).

Некоторые производители предлагают изготовление и монтаж под ключ (turnkey): изготовляют плату, закупают компоненты и выполняют монтаж. Это удобно и, по опыту разработчиков, не слишком дорого. Однако доставка нередко занимает много времени — 1–3 месяца.

При запросе стоимости на [PCBWay](https://www.pcbway.com/orderonline.aspx) услугу монтажа можно выбрать после загрузки файла Gerber.

Выбор услуги монтажа

На следующем этапе загрузите [BOM](v2/BOM_v2.csv) и [файл координат установки компонентов](v2/centroid_file_v2.csv). В течение нескольких дней производитель проверит и уточнит расчёт стоимости. После ознакомления со стоимостью и сроком доставки можно переходить к оплате.
