nitrobin/OpenBot/body/diy/cad/glue_body/README.de-DE.md

# Klebbares Chassis

<p align="center">
  <a href="README.ru-RU.md">Русский</a> |
  <a href="README.md">English</a> |
  <a href="README.zh-CN.md">简体中文</a> |
  <span>Deutsch</span> |
  <a href="README.fr-FR.md">Français</a> |
  <a href="README.es-ES.md">Español</a> |
  <a href="README.ko-KR.md">한국어</a>
</p>

Einige 3D-Drucker haben ein Bauvolumen, das zu klein ist, um den OpenBot-Körper in voller Größe zu drucken.
Dieser Ordner enthält den OpenBot-Körper, der in 4 Teile aufgeteilt ist.
Er kann mit einer Bauplatte gedruckt werden, die nur 150mm x 140mm groß ist, und dann zusammengeklebt werden.

Klebbares Chassis

## Teile

Erforderliche Teile:

1) `glue_body_bottom_A` ([STL](glue_body_bottom_A.stl), [STEP](glue_body_bottom_A.step))
2) `glue_body_bottom_B` ([STL](glue_body_bottom_B.stl), [STEP](glue_body_bottom_B.step))
3) `glue_body_top_A` ([STL](glue_body_top_A.stl), [STEP](glue_body_top_A.step))
4) `glue_body_top_B` ([STL](glue_body_top_B.stl), [STEP](glue_body_top_B.step))

Optionale Teile:

Diese Teile bieten zusätzliche Klebefläche, was hilfreich sein kann, wenn Ihr Druck Verformungen aufweist.

* `glue_connector_bottom` ([STL](glue_connector_bottom.stl), [STEP](glue_connector_bottom.step))
* `glue_connector_top_A` ([STL](glue_connector_top_A.stl), [STEP](glue_connector_top_A.step))
* `glue_connector_top_B` ([STL](glue_connector_top_B.stl), [STEP](glue_connector_top_B.step))
