nitrobin/OpenBot/body/diy/cad/glue_body/README.es-ES.md

# Cuerpo Pegable

<p align="center">
  <a href="README.ru-RU.md">Русский</a> |
  <a href="README.md">English</a> |
  <a href="README.zh-CN.md">简体中文</a> |
  <a href="README.de-DE.md">Deutsch</a> |
  <a href="README.fr-FR.md">Français</a> |
  <span>Español</span> |
  <a href="README.ko-KR.md">한국어</a>
</p>

Algunas impresoras 3D tienen volúmenes de construcción que son demasiado pequeños para imprimir el cuerpo de OpenBot a tamaño completo.
Esta carpeta contiene el cuerpo de OpenBot dividido en 4 piezas.
Se puede imprimir con una placa de construcción tan pequeña como 150mmx140mm, y luego pegarse.

Cuerpo Pegable

## Piezas

Piezas requeridas:

1) `glue_body_bottom_A` ([STL](glue_body_bottom_A.stl), [STEP](glue_body_bottom_A.step))
2) `glue_body_bottom_B` ([STL](glue_body_bottom_B.stl), [STEP](glue_body_bottom_B.step))
3) `glue_body_top_A` ([STL](glue_body_top_A.stl), [STEP](glue_body_top_A.step))
4) `glue_body_top_B` ([STL](glue_body_top_B.stl), [STEP](glue_body_top_B.step))

Piezas opcionales:

Estas piezas proporcionan una superficie adicional para pegar, lo cual puede ser útil si tu impresión experimenta deformaciones.

* `glue_connector_bottom` ([STL](glue_connector_bottom.stl), [STEP](glue_connector_bottom.step))
* `glue_connector_top_A` ([STL](glue_connector_top_A.stl), [STEP](glue_connector_top_A.step))
* `glue_connector_top_B` ([STL](glue_connector_top_B.stl), [STEP](glue_connector_top_B.step))
