nitrobin/OpenBot/body/diy/cad/glue_body/README.fr-FR.md

# Corps Collable

<p align="center">
  <a href="README.ru-RU.md">Русский</a> |
  <a href="README.md">English</a> |
  <a href="README.zh-CN.md">简体中文</a> |
  <a href="README.de-DE.md">Deutsch</a> |
  <span>Français</span> |
  <a href="README.es-ES.md">Español</a> |
  <a href="README.ko-KR.md">한국어</a>
</p>

Certaines imprimantes 3D ont des volumes de construction trop petits pour imprimer le corps OpenBot en taille réelle.
Ce dossier contient le corps OpenBot divisé en 4 pièces.
Il peut être imprimé avec une plaque de construction aussi petite que 150mmx140mm, puis collé ensemble.

Corps Collable

## Pièces

Pièces requises :

1) `glue_body_bottom_A` ([STL](glue_body_bottom_A.stl), [STEP](glue_body_bottom_A.step))
2) `glue_body_bottom_B` ([STL](glue_body_bottom_B.stl), [STEP](glue_body_bottom_B.step))
3) `glue_body_top_A` ([STL](glue_body_top_A.stl), [STEP](glue_body_top_A.step))
4) `glue_body_top_B` ([STL](glue_body_top_B.stl), [STEP](glue_body_top_B.step))

Pièces optionnelles :

Ces pièces offrent une surface supplémentaire pour le collage, ce qui peut être utile si votre impression subit des déformations.

* `glue_connector_bottom` ([STL](glue_connector_bottom.stl), [STEP](glue_connector_bottom.step))
* `glue_connector_top_A` ([STL](glue_connector_top_A.stl), [STEP](glue_connector_top_A.step))
* `glue_connector_top_B` ([STL](glue_connector_top_B.stl), [STEP](glue_connector_top_B.step))
