nitrobin/OpenBot/body/diy/cad/glue_body/README.ko-KR.md

# 조립식 본체

<p align="center">
  <a href="README.ru-RU.md">Русский</a> |
  <a href="README.md">English</a> |
  <a href="README.zh-CN.md">简体中文</a> |
  <a href="README.de-DE.md">Deutsch</a> |
  <a href="README.fr-FR.md">Français</a> |
  <a href="README.es-ES.md">Español</a> |
  <span>한국어</span>
</p>

어떤 3D 프린터는 OpenBot 몸체를 실제 크기로 출력하기엔 빌드 볼륨이 너무 작을 수 있어요.  
이 폴더에는 OpenBot 몸체를 4개의 조각으로 나눈 파일이 들어 있어요.  
150mm x 140mm 크기의 빌드 플레이트에서도 출력할 수 있고, 출력 후 조각들을 접착제로 붙이면 완성돼요.

붙이는 몸체

## 부품

**필수 부품**:

1) `glue_body_bottom_A` ([STL](glue_body_bottom_A.stl), [STEP](glue_body_bottom_A.step))
2) `glue_body_bottom_B` ([STL](glue_body_bottom_B.stl), [STEP](glue_body_bottom_B.step))
3) `glue_body_top_A` ([STL](glue_body_top_A.stl), [STEP](glue_body_top_A.step))
4) `glue_body_top_B` ([STL](glue_body_top_B.stl), [STEP](glue_body_top_B.step))

**선택 부품**:

이 부품들은 접착 면적을 더 넓혀줘요. 만약 출력물이 휨 현상을 겪는다면 도움이 될 수 있어요.

* `glue_connector_bottom` ([STL](glue_connector_bottom.stl), [STEP](glue_connector_bottom.step))
* `glue_connector_top_A` ([STL](glue_connector_top_A.stl), [STEP](glue_connector_top_A.step))
* `glue_connector_top_B` ([STL](glue_connector_top_B.stl), [STEP](glue_connector_top_B.step))
