nitrobin/OpenBot/body/diy/cad/glue_body/README.md

# Glueable Body

<p align="center">
  <a href="README.ru-RU.md">Русский</a> |
  <span>English</span> |
  <a href="README.zh-CN.md">简体中文</a> |
  <a href="README.de-DE.md">Deutsch</a> |
  <a href="README.fr-FR.md">Français</a> |
  <a href="README.es-ES.md">Español</a> |
  <a href="README.ko-KR.md">한국어</a>
</p>

Some 3D printers have build volumes that are too small to print the full size OpenBot body.
This folder contains the OpenBot body split into 4 pieces.
It can be printed with a build plate as small as 150mmx140mm, and then glued together.

Glueable Body

## Parts

Required parts:

1) `glue_body_bottom_A` ([STL](glue_body_bottom_A.stl), [STEP](glue_body_bottom_A.step))
2) `glue_body_bottom_B` ([STL](glue_body_bottom_B.stl), [STEP](glue_body_bottom_B.step))
3) `glue_body_top_A` ([STL](glue_body_top_A.stl), [STEP](glue_body_top_A.step))
4) `glue_body_top_B` ([STL](glue_body_top_B.stl), [STEP](glue_body_top_B.step))

Optional parts:

These pieces give extra surface area for gluing, which can help if your print experiences warping.

* `glue_connector_bottom` ([STL](glue_connector_bottom.stl), [STEP](glue_connector_bottom.step))
* `glue_connector_top_A` ([STL](glue_connector_top_A.stl), [STEP](glue_connector_top_A.step))
* `glue_connector_top_B` ([STL](glue_connector_top_B.stl), [STEP](glue_connector_top_B.step))
