nitrobin/OpenBot/body/diy/cad/glue_body/README.ru-RU.md

# Корпус из склеиваемых частей (Glueable Body)

<p align="center">
  <span>Русский</span> |
  <a href="README.md">English</a> |
  <a href="README.zh-CN.md">简体中文</a> |
  <a href="README.de-DE.md">Deutsch</a> |
  <a href="README.fr-FR.md">Français</a> |
  <a href="README.es-ES.md">Español</a> |
  <a href="README.ko-KR.md">한국어</a>
</p>

Терминология: [глоссарий OpenBot DIY](../../../../GLOSSARY.ru-RU.md).

Рабочий объём некоторых 3D-принтеров слишком мал для печати полноразмерного корпуса OpenBot. В этой папке находится корпус, разделённый на четыре части. Их можно напечатать на платформе размером всего 150 × 140 мм, а затем склеить.

Корпус из склеиваемых частей

## Детали

Обязательные детали:

1. `glue_body_bottom_A` ([STL](glue_body_bottom_A.stl), [STEP](glue_body_bottom_A.step)).
2. `glue_body_bottom_B` ([STL](glue_body_bottom_B.stl), [STEP](glue_body_bottom_B.step)).
3. `glue_body_top_A` ([STL](glue_body_top_A.stl), [STEP](glue_body_top_A.step)).
4. `glue_body_top_B` ([STL](glue_body_top_B.stl), [STEP](glue_body_top_B.step)).

Дополнительные детали:

Эти соединительные элементы увеличивают площадь склеивания. Они могут быть полезны при короблении (warping) напечатанных деталей.

- `glue_connector_bottom` ([STL](glue_connector_bottom.stl), [STEP](glue_connector_bottom.step)).
- `glue_connector_top_A` ([STL](glue_connector_top_A.stl), [STEP](glue_connector_top_A.step)).
- `glue_connector_top_B` ([STL](glue_connector_top_B.stl), [STEP](glue_connector_top_B.step)).
