nitrobin/OpenBot/body/diy/cad/regular_body/README.de-DE.md

# Reguläres Gehäuse

<p align="center">
  <a href="README.ru-RU.md">Русский</a> |
  <a href="README.md">English</a> |
  <a href="README.zh-CN.md">简体中文</a> |
  <span>Deutsch</span> |
  <a href="README.fr-FR.md">Français</a> |
  <a href="README.es-ES.md">Español</a> |
  <a href="README.ko-KR.md">한국어</a>
</p>

Zusammenbau

## Teile

Du musst die folgenden Teile drucken, um deinen OpenBot zu bauen.

- `body_bottom` ([STL](body_bottom.stl), [STEP](body_bottom.step))
- `body_top` ([STL](body_top.stl), [STEP](body_top.step))

Für die oben genannten Teile muss deine Druckplatte mindestens 240mm x 150mm groß sein.

## Druckeinstellungen

Auf einem Ultimaker S5 haben wir mit den folgenden Einstellungen gute Ergebnisse erzielt:

- Schichthöhe: 0,2mm
- Wandstärke: 1,5mm
- Fülldichte: 20%
- Füllmuster: Gitter
- Druckgeschwindigkeit: 80 mm/s
- keine Unterstützung

Wir konnten das Chassis mit PLA, ABS und CPE drucken. Nach unserer Erfahrung wurden die Druckergebnisse nicht stark von den Druckeinstellungen beeinflusst. Wenn du jedoch Geduld hast, wird ein langsamerer Druck mit kleinerer Schichthöhe die Druckqualität verbessern. Auch das Hinzufügen einer Stützstruktur kann den Druck verbessern, erfordert jedoch zusätzliche Arbeit, um sie nach dem Druck zu entfernen.
