nitrobin/OpenBot/body/diy/cad/regular_body/README.es-ES.md

# Cuerpo Regular

<p align="center">
  <a href="README.ru-RU.md">Русский</a> |
  <a href="README.md">English</a> |
  <a href="README.zh-CN.md">简体中文</a> |
  <a href="README.de-DE.md">Deutsch</a> |
  <a href="README.fr-FR.md">Français</a> |
  <span>Español</span> |
  <a href="README.ko-KR.md">한국어</a>
</p>

Assembly

## Piezas

Necesitarás imprimir las siguientes piezas para construir tu OpenBot.

- `body_bottom` ([STL](body_bottom.stl), [STEP](body_bottom.step))
- `body_top` ([STL](body_top.stl), [STEP](body_top.step))

Para las piezas mencionadas, tu placa de construcción necesita ser al menos de 240mmx150mm.

## Configuración de Impresión

En una Ultimaker S5, logramos buenos resultados con las siguientes configuraciones:

- altura de capa: 0.2mm
- grosor de pared: 1.5mm
- densidad de relleno: 20%
- patrón de relleno: cuadrícula
- velocidad de impresión: 80 mm/s
- sin soporte

Pudimos imprimir el chasis con PLA, ABS y CPE. En nuestra experiencia, la impresión no se vio muy afectada por las configuraciones de impresión. Sin embargo, si tienes paciencia, imprimir más lento y con una altura de capa menor mejorará la impresión. Además, agregar una estructura de soporte puede mejorar la impresión, pero requerirá trabajo adicional para removerla posteriormente.
