nitrobin/OpenBot/body/diy/cad/regular_body/README.fr-FR.md

# Corps Régulier

<p align="center">
  <a href="README.ru-RU.md">Русский</a> |
  <a href="README.md">English</a> |
  <a href="README.zh-CN.md">简体中文</a> |
  <a href="README.de-DE.md">Deutsch</a> |
  <span>Français</span> |
  <a href="README.es-ES.md">Español</a> |
  <a href="README.ko-KR.md">한국어</a>
</p>

Assembly

## Pièces

Vous devrez imprimer les pièces suivantes pour construire votre OpenBot.

- `body_bottom` ([STL](body_bottom.stl), [STEP](body_bottom.step))
- `body_top` ([STL](body_top.stl), [STEP](body_top.step))

Pour les pièces ci-dessus, votre plateau d'impression doit mesurer au moins 240mm x 150mm.

## Paramètres d'impression

Sur une Ultimaker S5, nous avons obtenu de bons résultats avec les paramètres suivants :

- hauteur de couche : 0,2mm
- épaisseur de paroi : 1,5mm
- densité de remplissage : 20%
- motif de remplissage : grille
- vitesse d'impression : 80 mm/s
- sans support

Nous avons pu imprimer le châssis avec du PLA, de l'ABS et du CPE. D'après notre expérience, les paramètres d'impression n'ont pas beaucoup affecté l'impression. Cependant, si vous avez de la patience, imprimer plus lentement et avec une hauteur de couche plus petite améliorera l'impression. Ajouter une structure de support peut également améliorer l'impression, mais nécessitera un travail supplémentaire pour l'enlever par la suite.
