nitrobin/OpenBot/body/diy/cad/regular_body/README.ko-KR.md

# 순정 몸체

<p align="center">
  <a href="README.ru-RU.md">Русский</a> |
  <a href="README.md">English</a> |
  <a href="README.zh-CN.md">简体中文</a> |
  <a href="README.de-DE.md">Deutsch</a> |
  <a href="README.fr-FR.md">Français</a> |
  <a href="README.es-ES.md">Español</a> |
  <span>한국어</span>
</p>

Assembly

## 부품

OpenBot을 조립하려면 다음 부품을 출력해야 해요!

- `body_bottom` ([STL](body_bottom.stl), [STEP](body_bottom.step))
- `body_top` ([STL](body_top.stl), [STEP](body_top.step))

위의 부품을 출력하려면 빌드 플레이트 크기가 최소 240mmx150mm 이상이어야 해요.

## 출력 설정

Ultimaker S5에서 다음 설정으로 좋은 결과를 얻었어요:

- 층 높이: 0.2mm
- 벽 두께: 1.5mm
- 밀도: 20%
- 채움 패턴: 격자(grid)
- 출력 속도: 80mm/s
- 서포트 없음

PLA, ABS, CPE로 섀시를 출력했는데요, 설정에 크게 영향을 받지 않았어요! 하지만, 시간이 조금 더 있다면 출력 속도를 느리게 하고 층 높이를 줄이면 더 깔끔하게 출력될 거예요. 서포트 구조를 추가하면 더 나은 결과를 얻을 수 있지만, 출력 후 제거 작업이 필요해요!
