nitrobin/OpenBot/body/diy/cad/regular_body/README.zh-CN.md

# Regular Body

<p align="center">
  <a href="README.ru-RU.md">Русский</a> |
  <a href="README.md">English</a> |
  <span>简体中文</span> |
  <a href="README.de-DE.md">Deutsch</a> |
  <a href="README.fr-FR.md">Français</a> |
  <a href="README.es-ES.md">Español</a> |
  <a href="README.ko-KR.md">한국어</a>
</p>

Assembly

## 零件

您需要打印以下零件来组装您的 OpenBot。

- `body_bottom` ([STL](body_bottom.stl), [STEP](body_bottom.step))
- `body_top` ([STL](body_top.stl), [STEP](body_top.step))

对于上述零件，您的打印板需要至少为 240mmx150mm。

## 打印设置

在 Ultimaker S5 上，我们使用以下设置取得了良好的效果：

- 层高：0.2mm
- 壁厚：1.5mm
- 填充密度：20%
- 填充图案：网格
- 打印速度：80 mm/s
- 无支撑

我们能够使用 PLA、ABS 和 CPE 打印底盘。根据我们的经验，打印设置对打印结果的影响不大。然而，如果您有耐心，较慢的打印速度和较小的层高将改善打印效果。此外，添加支撑结构可以改善打印，但之后需要额外的工作来移除。
