nitrobin/OpenBot/GLOSSARY.ru-RU.md

# Глоссарий русской документации OpenBot DIY

Этот файл задаёт терминологию для русских инструкций по механической сборке, электронике, 3D-печати, прошивке и вводу OpenBot DIY в эксплуатацию. При переводе и последующих правках используйте приведённые здесь варианты единообразно.

## Правила перевода

1. Используйте принятый русский технический термин для описания деталей и действий. Обозначения контактов, разъёмов, сигналов, параметров и пунктов интерфейса всегда приводите в исходном написании. Русское пояснение добавляйте рядом; оно не заменяет маркировку. Например: `GND` (общий провод), `Echo` (эхо-сигнал), `Wall Line Count` (число линий стенки).
2. Сохраняйте названия изделий, библиотек, файлов, команд, макросов и сигналов: `Arduino Nano`, `ESP32`, `L298N`, `DIY_ESP32`, `TICKS_PER_REV`, `OUT1`, `Echo`, `Trigger`, `GND`. Регистр букв, цифры и знаки также сохраняйте: `D0` и `DO` — разные записи. Не переводите текст внутри команд и примеров протокола.
3. Названия пунктов интерфейса Arduino IDE, Android Studio и слайсера сохраняйте на английском, как на иллюстрациях. Перед названием можно добавить русское пояснение: «монитор последовательного порта (`Serial Monitor`)».
4. Различайте корпус и шасси, двигатель и мотор-редуктор, колесо и шину, разъём и его отдельный контакт, аккумулятор и аккумуляторную батарею. Не заменяйте точные понятия общим словом «модуль».
5. Указывайте единицы после числа с пробелом: `5 В`, `150 Ом`, `20 кОм`, `0,2 мм`, `80 мм/с`, `50 %`. Размеры записывайте через знак умножения: `240 × 150 мм`, `M3 × 25`. В коде, URL и именах файлов исходную запись сохраняйте.
6. Переводите `rpm` как «об/мин», а не «обороты в секунду». Для относительной длительности импульса ШИМ используйте «коэффициент заполнения». Скважность — обратная величина; эти термины не взаимозаменяемы.
7. При каждом упоминании общего провода обязательно указывайте `GND`: `GND` (общий провод) или общий провод (`GND`). В этой документации это опорный потенциал схемы; обозначение `GND` само по себе не подразумевает защитное заземление `PE`.
8. Сохраняйте последовательность операций, полярность, номера выводов, номиналы, размеры и предупреждения. Если исходная инструкция противоречит коду, указывайте проверенное уточнение отдельно, со ссылкой на файл; не скрывайте исправление внутри перевода.
9. Новые переводы добавляйте как `README.ru-RU.md` рядом с другими локализациями. Связывайте русские инструкции между собой, сохраняя ссылки на исходные модели, схемы, фотографии и английские документы, у которых ещё нет перевода.

## Как читать обозначения контактов и разъёмов

В инструкции по подключению указывайте **точную маркировку обоих концов соединения и название каждой платы**. Например: «соедините `SCL` OLED-дисплея с `A5` Arduino Nano». Одного русского названия функции контакта недостаточно для определения места подключения.

| Исходное обозначение | Пояснение | Что нужно различать |
| --- | --- | --- |
| `GND` | Общий провод (`GND`) | В схеме OpenBot к нему подключается минус питания; защитное заземление обозначается `PE`. |
| `5V`, `+12V`, `3V3` | Обозначения цепей питания | Сохраняйте запись с конкретной платы. Напряжение питания и допустимый уровень сигнала — разные характеристики. |
| `VIN`, `Vin`, `VCC` | Обозначения питания конкретного узла | Назначение и допустимое напряжение определяются документацией этой платы. `VIN` OLED-дисплея, `VIN` Arduino и `Vin` специализированной PCB относятся к разным узлам; их нельзя объединять общим переводом «питание». |
| `D2`, `D3`, `A4`, `A5`, `A7` | Обозначения выводов Arduino Nano | Название `D2` на Arduino Nano не означает `GPIO2` ESP32. Для другой платы требуется её собственная схема выводов. |
| `D0` | Обозначение, зависящее от устройства | В текстовой инструкции `D0` датчика частоты вращения обозначает его цифровой выход. В схеме DIY он подключается к `D2` или `D3` Arduino Nano, а не к одноимённому `D0` Arduino. Всегда называйте устройство вместе с контактом. |
| `GPIO` | Вывод ввода-вывода микроконтроллера | Номер GPIO относится к сигналу микроконтроллера, а не обязательно к порядковому номеру контакта на разъёме платы. |
| `OUT1`, `OUT2`, `OUT3`, `OUT4` | Выходы драйвера L298N | Сохраняйте номера и указанную в инструкции полярность подключения двигателей. |
| `M1`, `M2`, `M3`, `M4` | Разъёмы двигателей на специализированной PCB | Здесь `M3` — маркировка разъёма. В строке «винт M3 × 25» `M3` обозначает метрическую резьбу, а не разъём. |
| `Echo`, `Trig`, `Trigger` | Сигналы ультразвукового дальномера | Сохраняйте написание из конкретной схемы и маркировки. Русское «эхо» или «запуск» само по себе не является именем контакта. |
| `SCL`, `SDA` | Тактовая линия и линия данных I2C | Это две разные линии; в инструкциях оставляйте `SCL` и `SDA`, даже если рядом есть русское пояснение. |
| `SONAR`, `SPEED_L`, `SPEED_R`, `SIGNAL_L`, `SIGNAL_R`, `IO2` | Маркировка разъёмов специализированной PCB | Сохраняйте обозначения целиком. Суффиксы `_L` и `_R` различают левую и правую стороны. |
| `PIN_VIN`, `PIN_ECHO`, `PIN_TRIGGER` | Имена настроек в прошивке | Это программные имена, а не обязательно надписи на плате. Например, `PIN_VIN` задаёт вход измерения напряжения через делитель; это не указание подключать батарею к контакту `VIN` микроконтроллерной платы. |

Источники конкретных соединений: [инструкция DIY](body/diy/README.ru-RU.md) и блок выбранной аппаратной конфигурации в [прошивке](firmware/openbot/openbot.ino). Назначение контактов Arduino Nano и ESP32 описывается отдельно; одинаковые слова в их названиях не задают одинакового подключения.

**Различие маркировки в исходных материалах:** питание OLED-дисплея в текстовой инструкции названо `VIN`, а на [схеме соединений](docs/images/wiring_diagram.png) — `VCC`. При работе с конкретным модулем сверяйте его маркировку и допустимое питание с документацией этого модуля. Такое расхождение не является основанием считать `VIN` и `VCC` взаимозаменяемыми на всех платах.

## Механика и сборка

| Английский термин | Русский термин | Уточнение |
| --- | --- | --- |
| DIY; do it yourself | самостоятельная сборка; DIY | `OpenBot DIY` — название варианта робота, его сохраняем. |
| assembly | сборка | Для электронных компонентов на плате — «монтаж». |
| robot body; body | корпус робота; корпус | Оболочка и несущие детали корпуса. |
| chassis | шасси | Несущая конструкция с ходовой частью; не всегда совпадает с корпусом. |
| bottom plate; body bottom | нижняя панель корпуса | Деталь `body_bottom`. |
| top plate; top cover | верхняя панель; крышка корпуса | Выбор зависит от функции детали. |
| bumper | бампер | Механическая деталь; `bumper sensor` — датчик столкновения. |
| phone mount | держатель смартфона | Узел фиксации телефона на корпусе. |
| rim | бортик | Кромка детали; не путать с каймой для 3D-печати. |
| motor | электродвигатель; двигатель | Электромеханический привод без указания редуктора. |
| geared motor; TT motor | мотор-редуктор; мотор-редуктор TT | Двигатель с редуктором. |
| shaft | вал | Вращающийся элемент двигателя или редуктора. |
| wheel | колесо | Весь узел колеса. |
| tire; tyre | шина | Эластичная часть колеса. |
| screw; nut | винт; гайка | В `M3 × 25` число 3 — номинальный диаметр метрической резьбы в мм, 25 — длина винта в мм. Гайка `M3` соответствует этой резьбе. |
| encoder disk | диск энкодера | Здесь — диск с прорезями, который вращается вместе с валом и проходит через оптический датчик. Сам диск не содержит электроники. |
| heat-shrink tubing | термоусадочная трубка | Изоляция соединения после пайки. |
| warping | коробление | Деформация печатной детали. |

## 3D-печать и конструкторские данные

| Английский термин | Русский термин | Уточнение |
| --- | --- | --- |
| CAD | система автоматизированного проектирования; САПР | `CAD model` — CAD-модель, трёхмерная модель детали. |
| STL | формат STL | Описывает поверхность детали треугольной сеткой; часто используется для подготовки к 3D-печати в слайсере. |
| STEP | формат STEP | Формат обмена геометрией CAD-моделей; удобен для работы с деталями в САПР. STL и STEP — разные представления модели, а не два имени одного формата. |
| build plate; print bed | платформа печати | Физическая площадка под деталью. Её размер может отличаться от доступной области печати. |
| build volume | рабочий объём принтера | Допустимые размеры печати по осям X, Y и Z. Для размещения корпуса на платформе отдельно проверяют X и Y. |
| build area | доступная область печати | Область X–Y, которую принтер и выбранный профиль слайсера позволяют использовать. |
| footprint | габариты детали в плоскости печати | Место, которое занимает деталь на платформе. Кайма и другие вспомогательные структуры также требуют места. |
| slicer | слайсер | Программа подготовки модели к 3D-печати. |
| layer height | высота слоя | `Layer Height`: толщина одного слоя по оси Z в мм. Это отдельный параметр от диаметра сопла. |
| wall thickness | толщина стенки | `Wall Thickness`: размер стенки в мм. Число линий стенки и их ширина влияют на получаемую толщину. |
| wall line count; perimeters | число линий стенки; периметры | `Wall Line Count` — количество линий, а не толщина в мм. Для сопоставления со слайсером сохраняйте его название параметра. |
| top layers; bottom layers | число верхних слоёв; число нижних слоёв | `Top Layers`, `Bottom Layers`: количество сплошных слоёв. Например, 5 слоёв по 0,2 мм дают около 1 мм толщины по Z. |
| infill; infill density | заполнение; плотность заполнения | Внутренняя структура детали. |
| infill pattern | рисунок заполнения | `Grid` — сетка; `Concentric` — концентрический. |
| print speed | скорость печати | Обычно в мм/с. |
| support; support structure | поддержки | Вспомогательные структуры для печати нависающих участков. |
| support density | плотность поддержек | Доля заполнения структуры поддержек. |
| brim | кайма | Однослойное расширение основания детали для сцепления с платформой. |
| skirt | юбка | Обводной контур вокруг детали, не соединённый с ней. |
| raft | подложка | Вспомогательное основание под деталью. |
| build plate adhesion | сцепление с платформой печати | Название параметра `Build Plate Adhesion Type` сохраняем. |
| prime blob | стартовая капля пластика | Выдавливается перед началом печати. |
| extruder | экструдер | Узел подачи материала. |
| PLA; ABS; CPE | PLA; ABS; CPE | Обозначения материалов сохраняем. |

## Электроника

| Английский термин | Русский термин | Уточнение |
| --- | --- | --- |
| printed circuit board; PCB | печатная плата; PCB | Сокращение `PCB` удобно для сопоставления с исходником. |
| custom PCB | специализированная печатная плата | Плата, разработанная для OpenBot. |
| carrier board | плата-носитель | Плата, в которую устанавливается Arduino Nano. |
| perfboard | перфорированная макетная плата | Плата для паяного монтажа; не беспаечная макетная плата. |
| motor driver | драйвер двигателей | Например, L298N: получает управляющие сигналы и подаёт питание на двигатели с нужным направлением и режимом управления. Это электронный узел, а не программный драйвер. |
| power distributor | распределитель питания | Узел разводки питания и общего провода (`GND`). |
| wiring; wiring diagram | монтаж проводов; схема соединений | Схема соединений не обязательно является принципиальной схемой. |
| connector; pin header | разъём; контактная колодка | Разъём содержит несколько контактов; один контакт — отдельная точка подключения. |
| male header; female header | штыревая колодка (male header); гнездовая колодка (female header) | Конструкция со штырями или гнёздами соответственно. Эти слова не задают полярность или направление сигнала. |
| pin; lead | вывод; контакт | Указывайте маркировку конкретного вывода/контакта: например, `GND`, `D2`, `SCL`. Русское слово «вывод» не заменяет его имя. |
| battery cell | аккумуляторный элемент; аккумулятор | Один элемент. В этой сборке используются аккумуляторы формата 18650. Обозначение 18650 задаёт форм-фактор, а не ёмкость в мА·ч. |
| battery; battery pack | аккумуляторная батарея | В контексте питания OpenBot — батарея из соединённых аккумуляторов. При переводе списка деталей различайте один элемент 18650 и весь комплект питания. |
| battery holder; battery case | держатель аккумуляторов | Удерживает элементы и обеспечивает их электрическое соединение. Сам по себе держатель не выполняет зарядку аккумуляторов. |
| voltage divider | делитель напряжения | Резистивная цепь, уменьшающая измеряемое напряжение для входа АЦП. Это измерительная цепь, а не источник питания для платы. |
| ADC; analog-to-digital converter | аналого-цифровой преобразователь; АЦП (ADC) | Преобразует входное напряжение в числовой отсчёт. Полученное число ещё нужно пересчитать в вольты с учётом опорного напряжения и делителя. |
| current-limiting resistor | токоограничивающий резистор | Например, последовательный резистор светодиода. |
| ground; GND | `GND` (общий провод) | Опорный потенциал схемы. Во всех употреблениях сохраняйте `GND`; для защитного заземления используется другое обозначение — `PE`. |
| LED; indicator LED | светодиод; светодиод указателя поворота | Для отдельной индикации состояния — «светодиод состояния». |
| OLED display | OLED-дисплей | `SSD1306` — обозначение контроллера дисплея. |
| bill of materials; BOM | перечень компонентов; BOM | Список компонентов для закупки и монтажа. |
| Gerber files | файлы Gerber | Данные для изготовления печатной платы. |
| centroid file; pick-and-place file | файл координат установки компонентов | Для автоматического монтажа, с положением и ориентацией компонентов. |
| surface-mount technology; SMT | технология поверхностного монтажа; SMT | Монтаж компонентов на поверхность платы. |
| through-hole components; THT | выводные компоненты; монтаж в отверстия | Выводы устанавливаются в отверстия платы. |
| turnkey assembly | изготовление и монтаж под ключ | Изготовление платы, закупка компонентов и монтаж. |

## Управление, датчики и программное обеспечение

| Английский термин | Русский термин | Уточнение |
| --- | --- | --- |
| microcontroller unit; MCU | микроконтроллер; MCU | Микросхема, выполняющая программу, например ATmega328P. Arduino Nano — плата с микроконтроллером. Название ESP32 может относиться к микросхеме, модулю или плате; уточняйте модель. |
| development board; development kit | отладочная плата; отладочный комплект | Например, ESP32 DevKit: плата с микроконтроллером и вспомогательными цепями. Назначение контактов проверяют для конкретной модели платы. |
| firmware | прошивка | Программа микроконтроллера. |
| flash; upload firmware | загрузить прошивку | Записать программу во флеш-память микроконтроллера. |
| bootloader | загрузчик | `Old Bootloader` — название настройки Arduino IDE. |
| PWM; pulse-width modulation | широтно-импульсная модуляция; ШИМ (PWM) | Управление длительностью включения импульсов. Если параметр или контакт обозначен `PWM`, это обозначение сохраняйте. |
| duty cycle | коэффициент заполнения (duty cycle) | Доля периода, в течение которой импульс активен: 0–100 %. Заполнение 50 % не гарантирует половину максимальной частоты вращения двигателя. |
| low-level control | низкоуровневое управление | Формирование сигналов приводов и обработка датчиков. |
| speed sensor | датчик частоты вращения | В OpenBot DIY — оптический датчик, считающий прохождение прорезей диска энкодера. Он измеряет вращение, а не скорость перемещения робота в м/с. |
| ultrasonic sensor; sonar | ультразвуковой дальномер | Измеряет расстояние до препятствия. `SONAR` как метку разъёма сохраняем. |
| bumper sensor | датчик столкновения | Срабатывает при контакте бампера с препятствием. |
| wheel odometry | колёсная одометрия | Оценка движения по вращению колёс. Проскальзывание колёс создаёт ошибку; это не прямое измерение положения робота. |
| rpm; revolutions per minute | обороты в минуту; об/мин | Частота вращения, а не линейная скорость робота. |
| ticks per revolution | отсчёты на оборот (ticks per revolution) | `TICKS_PER_REV` в текущей прошивке. Для стандартного диска DIY — 20; для вариантов с другими энкодерами и редукторами значения иные. Число прорезей диска не является универсальным значением для всех OpenBot. |
| interrupt; pin-change interrupt | прерывание; прерывание по изменению состояния вывода | Термин «прерывание» не заменяем «сигналом». |
| serial connection; serial monitor | последовательное соединение; монитор последовательного порта | `Serial Monitor` — пункт интерфейса Arduino IDE. |
| baud rate | скорость передачи в бодах | Например, `Upload Speed` в Arduino IDE. Это скорость обмена данными, а не частота ШИМ или частота вращения. |
| moving average; median filter | скользящее среднее; медианный фильтр | Первое усредняет несколько отсчётов; второй выбирает срединное значение упорядоченного набора и помогает подавлять одиночные выбросы. |
| heartbeat | сообщение контроля активности | Подтверждает активность управляющего устройства. |
| state of charge; SOC | степень заряженности; SOC | Оценка доли оставшегося заряда. Напряжение батареи в вольтах и SOC в процентах — разные величины. |
| controller; game controller | пульт управления; игровой контроллер | Для платы электроники используем «контроллер» или «плата управления» по контексту. |
| teleoperation | дистанционное управление | Управление роботом оператором по каналу связи. |
| API level; SDK | уровень API; комплект средств разработки SDK | Номер API Android задаёт версию программного интерфейса. SDK содержит средства сборки и разработки. |
| minSdkVersion; compileSdkVersion; targetSdkVersion | `minSdkVersion`; `compileSdkVersion`; `targetSdkVersion` | Минимальный API устройства, API для сборки и целевой API поведения приложения соответственно. Эти настройки выполняют разные задачи; имена сохраняйте. |
| build; deploy | собрать приложение; установить и запустить | Не смешиваем сборку приложения с механической сборкой. |

## Терминологические ориентиры

- [Русское руководство KiCad: редактор печатных плат](https://docs.kicad.org/8.0/ru/pcbnew/pcbnew.html) — терминология печатных плат, контактных площадок, посадочных мест и производственных данных.
- [Arduino: широтно-импульсная модуляция](https://docs.arduino.cc/tutorials/generic/secrets-of-arduino-pwm/) — смысл PWM и duty cycle; русские эквиваленты зафиксированы выше.
- [Arduino Nano: паспорт платы](https://docs.arduino.cc/resources/datasheets/A000005-datasheet.pdf) — обозначения и назначение контактов питания именно классической Arduino Nano.
- [Prusa: заполнение в 3D-печати](https://help.prusa3d.com/article/infill_42) — различие параметров заполнения, стенок и слоёв.
- [Prusa: слои и периметры](https://help.prusa3d.com/article/layers-and-perimeters_1748) — высота слоя, линии стенки и толщина верхних/нижних поверхностей.
- [Исходная прошивка OpenBot](firmware/openbot/openbot.ino) — точные имена параметров, сигналы и единицы телеметрии для этой версии проекта.

Если появляется новый неоднозначный термин, сначала дополните глоссарий, затем используйте выбранный вариант во всех русских документах.
