nitrobin/OpenBot/body/README.fr-FR.md

# OpenBot : Corps de Robot

<p align="center">
  <a href="README.ru-RU.md">Русский</a> |
  <a href="README.md">English</a> |
  <a href="README.zh-CN.md">简体中文</a> |
  <a href="README.de-DE.md">Deutsch</a> |
  <span>Français</span> |
  <a href="README.es-ES.md">Español</a> |
  <a href="README.ko-KR.md">한국어</a>
</p>

Vous pouvez acheter un OpenBot [prêt à l'emploi (RTR)](rtr) sur Amazon :
- [RTR-TT](https://buy.openbot.org/rtr-tt)
- [RTR-520](https://buy.openbot.org/rtr-520)

Pour des demandes de commandes plus importantes, veuillez nous contacter par email.

## Construire le vôtre

Vous pouvez construire n'importe quel robot à roues autour d'un microcontrôleur tel que l'Arduino Nano pour l'utiliser avec la pile logicielle OpenBot. Nous avons conçu un [corps imprimé en 3D](diy) pour un robot à roues qui repose sur du matériel de loisir peu coûteux et facilement disponible. [OpenBot Lite](lite) est une variante plus petite et simplifiée de la version DIY d'OpenBot développée pour l'éducation. Même si vous ne souhaitez pas le construire, vous pouvez trouver les [guides vidéo étape par étape](lite/#step-by-step-video-guides) utiles. Nous avons également conçu un [corps imprimé en 3D](rc_truck) pour des camions RC 1:16 disponibles dans le commerce (comme [celui-ci](https://www.amazon.de/dp/B00M3J7DJW)). Nous fournissons également des plans pour construire un [véhicule tout-terrain](mtv), en tant que plateforme polyvalente pour des projets extérieurs utilisant le cadre OpenBot.

Voici quelques exemples avec des instructions de construction et plus de détails :

<table style="width:100%;border:none;text-align:center">
  <tr>
  <td>  <a href="diy">
    DIY
  </a>
  </td>
  <td>
  <a href="lite">
    Lite
  </a>
  </td>
  <td>
  <a href="rc_truck">
    RC Truck
  </a>
  </td>
  <td>
  <a href="mtv">
    Multi-Terrain Vehicle
  </a>
  </td>
  <td>
  <a href="rtr">
    RTR
  </a>
  </td>
  </tr>
  <tr>
    <td><a href="diy"> DIY </a></td>
    <td><a href="lite"> Lite </a></td>
    <td><a href="rc_truck"> RC Truck </a></td>
    <td><a href="mtv"> Multi-Terrain Vehicle </a></td>
    <td><a href="rtr"> RTR </a></td>
  </tr>
</table>

## Ensuite

Flashez le [Firmware Arduino](../firmware/README.md)
