nitrobin/OpenBot/body/README.ru-RU.md

# OpenBot: корпус робота

<p align="center">
  <span>Русский</span> |
  <a href="README.md">English</a> |
  <a href="README.zh-CN.md">简体中文</a> |
  <a href="README.de-DE.md">Deutsch</a> |
  <a href="README.fr-FR.md">Français</a> |
  <a href="README.es-ES.md">Español</a> |
  <a href="README.ko-KR.md">한국어</a>
</p>

Терминология: [глоссарий OpenBot DIY](../GLOSSARY.ru-RU.md).

Готовый к эксплуатации OpenBot ([ready-to-run, RTR](rtr)) можно приобрести на Amazon:

- [RTR-TT](https://buy.openbot.org/rtr-tt)
- [RTR-520](https://buy.openbot.org/rtr-520)

По вопросам крупных заказов свяжитесь с командой проекта по электронной почте.

## Самостоятельная сборка

Для работы с программным обеспечением OpenBot можно собрать любое колёсное шасси с микроконтроллером, например Arduino Nano. Разработчики подготовили [корпус для 3D-печати](diy/README.ru-RU.md), рассчитанный на недорогие и доступные компоненты для любительской робототехники. [OpenBot Lite](lite) — уменьшенный и упрощённый вариант OpenBot DIY для обучения. Даже если вы не планируете собирать Lite, его [пошаговые видеоинструкции](lite/#step-by-step-video-guides) могут быть полезны. Также разработан [корпус для 3D-печати](rc_truck) для серийных радиоуправляемых грузовиков масштаба 1:16, например [этой модели](https://www.amazon.de/dp/B00M3J7DJW). Для проектов на открытом воздухе доступны чертежи [вездеходной платформы](mtv) на базе OpenBot.

Ниже приведены варианты конструкции со ссылками на инструкции по сборке и подробные описания:

<table style="width:100%;border:none;text-align:center">
  <tr>
    <td><a href="diy/README.ru-RU.md">OpenBot DIY</a></td>
    <td><a href="lite">OpenBot Lite</a></td>
    <td><a href="rc_truck">Радиоуправляемый грузовик</a></td>
    <td><a href="mtv">Вездеходная платформа</a></td>
    <td><a href="rtr">Готовый к эксплуатации OpenBot</a></td>
  </tr>
  <tr>
    <td><a href="diy/README.ru-RU.md">DIY</a></td>
    <td><a href="lite">Lite</a></td>
    <td><a href="rc_truck">RC Truck</a></td>
    <td><a href="mtv">Multi-Terrain Vehicle</a></td>
    <td><a href="rtr">RTR</a></td>
  </tr>
</table>

## Следующий шаг

Загрузите [прошивку микроконтроллера](../firmware/README.ru-RU.md).
