nitrobin/OpenBot/DISCLAIMER.de-DE.md

## HAFTUNGSAUSSCHLUSS

<p align="center">
  <a href="DISCLAIMER.ru-RU.md">Русский</a> |
  <a href="DISCLAIMER.md">English</a> |
  <a href="DISCLAIMER.zh-CN.md">简体中文</a> |
  <span>Deutsch</span> |
  <a href="DISCLAIMER.fr-FR.md">Français</a> |
  <a href="DISCLAIMER.es-ES.md">Español</a> |
  <a href="DISCLAIMER.ko-KR.md">한국어</a>
</p>

Das OpenBot-Projekt ist eine Open-Source-Initiative, die darauf abzielt, zugängliche Robotiklösungen für Bildungs-, Experimentier- und Freizeitzwecke bereitzustellen. Der folgende Haftungsausschluss beschreibt die Nutzungsbedingungen für die OpenBot-Software und Hardware-Designs.

### Software-Haftungsausschluss

- Die OpenBot-Software wird ohne jegliche ausdrückliche oder stillschweigende Gewährleistung bereitgestellt.
- Die Mitwirkenden und Betreuer des OpenBot-Projekts sind nicht verantwortlich für Schäden oder Datenverluste, die durch die Nutzung der Software entstehen können.
- Die Benutzer sind dafür verantwortlich, sicherzustellen, dass ihre Nutzung der OpenBot-Software allen relevanten Gesetzen und Vorschriften entspricht.
- Der Missbrauch der Software für böswillige oder unethische Zwecke ist strengstens untersagt.

### Hardware-Haftungsausschluss

- Die OpenBot-Hardware-Designs werden zu Bildungs- und Experimentierzwecken bereitgestellt und sind möglicherweise nicht für alle Anwendungsfälle geeignet.
- Die Benutzer sind dafür verantwortlich, sicherzustellen, dass ihre Implementierung der OpenBot-Hardware den Sicherheitsstandards und Vorschriften ihrer Region entspricht.
- Die Mitwirkenden und Betreuer des OpenBot-Projekts haften nicht für Verletzungen, Schäden oder Verluste, die durch den Bau, die Modifikation oder den Betrieb von Robotern auf Basis der OpenBot-Hardware-Designs entstehen.
- Die Benutzer werden aufgefordert, Vorsicht walten zu lassen und die Sicherheit zu priorisieren, wenn sie Roboter auf Basis von OpenBot bauen und betreiben.

### Allgemeiner Haftungsausschluss

- Die Mitwirkenden und Betreuer des OpenBot-Projekts lehnen jegliche Haftung für Schäden oder Verluste ab, die direkt oder indirekt aus der Nutzung oder dem Missbrauch der OpenBot-Software und Hardware-Designs entstehen.
- Die Benutzer werden ermutigt, die OpenBot-Ressourcen verantwortungsbewusst, ethisch und in Übereinstimmung mit allen geltenden Gesetzen und Vorschriften zu nutzen.

Durch die Nutzung der OpenBot-Software und Hardware-Designs erkennen Sie an, dass Sie die Bedingungen dieses Haftungsausschlusses gelesen, verstanden und akzeptiert haben.
