nitrobin/OpenBot/DISCLAIMER.es-ES.md

## AVISO LEGAL

<p align="center">
  <a href="DISCLAIMER.ru-RU.md">Русский</a> |
  <a href="DISCLAIMER.md">English</a> |
  <a href="DISCLAIMER.zh-CN.md">简体中文</a> |
  <a href="DISCLAIMER.de-DE.md">Deutsch</a> |
  <a href="DISCLAIMER.fr-FR.md">Français</a> |
  <span>Español</span> |
  <a href="DISCLAIMER.ko-KR.md">한국어</a>
</p>

El proyecto OpenBot es una iniciativa de código abierto que tiene como objetivo proporcionar soluciones robóticas accesibles para fines educativos, experimentales y recreativos. El siguiente aviso legal describe los términos y condiciones de uso del software y los diseños de hardware de OpenBot.

### Aviso Legal del Software

- El software de OpenBot se proporciona "tal cual" sin ninguna garantía de ningún tipo, expresa o implícita.
- Los colaboradores y mantenedores del proyecto OpenBot no son responsables de ningún daño o pérdida de datos que pueda resultar del uso del software.
- Los usuarios son responsables de asegurarse de que su uso del software de OpenBot cumpla con todas las leyes y regulaciones relevantes.
- El uso indebido del software para fines maliciosos o poco éticos está estrictamente prohibido.

### Aviso Legal del Hardware

- Los diseños de hardware de OpenBot se proporcionan para fines educativos y experimentales y pueden no ser adecuados para todos los casos de uso.
- Los usuarios son responsables de asegurarse de que su implementación del hardware de OpenBot cumpla con los estándares de seguridad y regulaciones aplicables a su región.
- Los colaboradores y mantenedores del proyecto OpenBot no son responsables de ninguna lesión, daño o pérdida resultante de la construcción, modificación u operación de robots basados en los diseños de hardware de OpenBot.
- Se insta a los usuarios a actuar con precaución y priorizar la seguridad al construir y operar robots basados en OpenBot.

### Aviso Legal General

- Los colaboradores y mantenedores del proyecto OpenBot declinan cualquier responsabilidad por daños o pérdidas incurridas directa o indirectamente por el uso o mal uso del software y los diseños de hardware de OpenBot.
- Se anima a los usuarios a utilizar los recursos de OpenBot de manera responsable, ética y en cumplimiento con todas las leyes y regulaciones aplicables.

Al usar el software y los diseños de hardware de OpenBot, usted reconoce que ha leído, entendido y aceptado los términos de este aviso legal.
