nitrobin/OpenBot/DISCLAIMER.fr-FR.md

## AVERTISSEMENT

<p align="center">
  <a href="DISCLAIMER.ru-RU.md">Русский</a> |
  <a href="DISCLAIMER.md">English</a> |
  <a href="DISCLAIMER.zh-CN.md">简体中文</a> |
  <a href="DISCLAIMER.de-DE.md">Deutsch</a> |
  <span>Français</span> |
  <a href="DISCLAIMER.es-ES.md">Español</a> |
  <a href="DISCLAIMER.ko-KR.md">한국어</a>
</p>

Le projet OpenBot est une initiative open-source visant à fournir des solutions robotiques accessibles à des fins éducatives, expérimentales et récréatives. Le présent avertissement décrit les termes et conditions d'utilisation des logiciels et des conceptions matérielles d'OpenBot.

### Avertissement sur le logiciel

- Le logiciel OpenBot est fourni "tel quel" sans aucune garantie, expresse ou implicite.
- Les contributeurs et mainteneurs du projet OpenBot ne sont pas responsables des dommages ou pertes de données pouvant résulter de l'utilisation du logiciel.
- Les utilisateurs sont responsables de s'assurer que leur utilisation du logiciel OpenBot est conforme à toutes les lois et réglementations en vigueur.
- L'utilisation abusive du logiciel à des fins malveillantes ou contraires à l'éthique est strictement interdite.

### Avertissement sur le matériel

- Les conceptions matérielles d'OpenBot sont fournies à des fins éducatives et expérimentales et peuvent ne pas convenir à tous les cas d'utilisation.
- Les utilisateurs sont responsables de s'assurer que leur mise en œuvre du matériel OpenBot est conforme aux normes de sécurité et aux réglementations applicables dans leur région.
- Les contributeurs et mainteneurs du projet OpenBot ne sont pas responsables des blessures, dommages ou pertes résultant de la construction, modification ou utilisation de robots basés sur les conceptions matérielles d'OpenBot.
- Les utilisateurs sont invités à faire preuve de prudence et à prioriser la sécurité lors de la construction et de l'utilisation de robots basés sur OpenBot.

### Avertissement général

- Les contributeurs et mainteneurs du projet OpenBot déclinent toute responsabilité pour les dommages ou pertes encourus directement ou indirectement par l'utilisation ou la mauvaise utilisation des logiciels et conceptions matérielles d'OpenBot.
- Les utilisateurs sont encouragés à utiliser les ressources d'OpenBot de manière responsable, éthique et en conformité avec toutes les lois et réglementations applicables.

En utilisant les logiciels et conceptions matérielles d'OpenBot, vous reconnaissez avoir lu, compris et accepté les termes de cet avertissement.
