nitrobin/OpenBot/DISCLAIMER.ko-KR.md

## 면책 조항

<p align="center">
  <a href="DISCLAIMER.ru-RU.md">Русский</a> |
  <a href="DISCLAIMER.md">English</a> |
  <a href="DISCLAIMER.zh-CN.md">简体中文</a> |
  <a href="DISCLAIMER.de-DE.md">Deutsch</a> |
  <a href="DISCLAIMER.fr-FR.md">Français</a> |
  <a href="DISCLAIMER.es-ES.md">Español</a> |
  <span>한국어</span>
</p>

OpenBot 프로젝트는 교육, 실험 및 오락 목적으로 접근 가능한 로봇 솔루션을 제공하는 오픈 소스 이니셔티브입니다. 다음 면책 조항은 OpenBot 소프트웨어 및 하드웨어 설계의 사용 조건을 설명합니다.

### 소프트웨어 면책 조항

- OpenBot 소프트웨어는 어떠한 종류의 보증 없이 "있는 그대로" 제공됩니다.
- OpenBot 프로젝트의 기여자 및 유지 관리자는 소프트웨어 사용으로 인해 발생할 수 있는 데이터 손실이나 손해에 대해 책임지지 않습니다.
- 사용자는 OpenBot 소프트웨어 사용이 모든 관련 법률 및 규정을 준수하는지 확인할 책임이 있습니다.
- 소프트웨어를 악의적이거나 비윤리적인 목적으로 잘못 사용하는 것은 엄격히 금지됩니다.

### 하드웨어 면책 조항

- OpenBot 하드웨어 설계는 교육 및 실험 목적으로 제공되며 모든 사용 사례에 적합하지 않을 수 있습니다.
- 사용자는 OpenBot 하드웨어의 구현이 해당 지역의 안전 기준 및 규정을 준수하는지 확인할 책임이 있습니다.
- OpenBot 프로젝트의 기여자 및 유지 관리자는 OpenBot 하드웨어 설계를 기반으로 한 로봇의 건설, 수정 또는 작동으로 인해 발생하는 부상, 손상 또는 손실에 대해 책임지지 않습니다.
- 사용자는 OpenBot 기반 로봇을 구축하고 운영할 때 주의를 기울이고 안전을 최우선으로 할 것을 권장합니다.

### 일반 면책 조항

- OpenBot 프로젝트의 기여자 및 유지 관리자는 OpenBot 소프트웨어 및 하드웨어 설계의 사용 또는 오용으로 인해 직접적 또는 간접적으로 발생하는 손해 또는 손실에 대한 책임을 부인합니다.
- 사용자는 OpenBot 리소스를 책임감 있게, 윤리적으로, 모든 적용 가능한 법률 및 규정을 준수하여 사용할 것을 권장합니다.

OpenBot 소프트웨어 및 하드웨어 설계를 사용함으로써, 귀하는 이 면책 조항의 내용을 읽고 이해하며 동의했음을 인정합니다.
