nitrobin/OpenBot/DISCLAIMER.md

## DISCLAIMER

<p align="center">
  <a href="DISCLAIMER.ru-RU.md">Русский</a> |
  <span>English</span> |
  <a href="DISCLAIMER.zh-CN.md">简体中文</a> |
  <a href="DISCLAIMER.de-DE.md">Deutsch</a> |
  <a href="DISCLAIMER.fr-FR.md">Français</a> |
  <a href="DISCLAIMER.es-ES.md">Español</a> |
  <a href="DISCLAIMER.ko-KR.md">한국어</a>
</p>

The OpenBot project is an open-source initiative aimed at providing accessible robotics solutions for educational, experimental, and recreational purposes. The following disclaimer outlines the terms and conditions of use for the OpenBot software and hardware designs.

### Software Disclaimer

- The OpenBot software is provided "as is" without any warranty of any kind, expressed or implied.
- The OpenBot project contributors and maintainers are not responsible for any damage or loss of data that may result from the use of the software.
- Users are responsible for ensuring that their use of the OpenBot software complies with all relevant laws and regulations.
- Misuse of the software for malicious or unethical purposes is strictly prohibited.

### Hardware Disclaimer

- The OpenBot hardware designs are provided for educational and experimental purposes and may not be suitable for all use cases.
- Users are responsible for ensuring that their implementation of the OpenBot hardware complies with safety standards and regulations applicable to their region.
- The OpenBot project contributors and maintainers are not liable for any injury, damage, or loss resulting from the construction, modification, or operation of robots based on the OpenBot hardware designs.
- Users are urged to exercise caution and prioritize safety when building and operating robots based on OpenBot.

### General Disclaimer

- The OpenBot project contributors and maintainers disclaim any liability for damages or losses incurred directly or indirectly from the use or misuse of the OpenBot software and hardware designs.
- Users are encouraged to use the OpenBot resources responsibly, ethically, and in compliance with all applicable laws and regulations.

By using the OpenBot software and hardware designs, you acknowledge that you have read, understood, and agreed to the terms of this disclaimer.
