nitrobin/OpenBot/DISCLAIMER.ru-RU.md

## Отказ от ответственности

<p align="center">
  <span>Русский</span> |
  <a href="DISCLAIMER.md">English</a> |
  <a href="DISCLAIMER.zh-CN.md">简体中文</a> |
  <a href="DISCLAIMER.de-DE.md">Deutsch</a> |
  <a href="DISCLAIMER.fr-FR.md">Français</a> |
  <a href="DISCLAIMER.es-ES.md">Español</a> |
  <a href="DISCLAIMER.ko-KR.md">한국어</a>
</p>

OpenBot — проект с открытым исходным кодом, цель которого — сделать робототехнику доступнее для обучения, экспериментов и досуга. Ниже изложены условия использования программного обеспечения и аппаратных разработок OpenBot.

### Программное обеспечение

- Программное обеспечение OpenBot предоставляется «как есть», без каких-либо явно выраженных или подразумеваемых гарантий.
- Участники и сопровождающие проекта OpenBot не несут ответственности за ущерб или потерю данных, которые могут возникнуть в результате использования программного обеспечения.
- Пользователи самостоятельно отвечают за соблюдение всех применимых законов и нормативных требований при использовании программного обеспечения OpenBot.
- Использование программного обеспечения в злонамеренных или неэтичных целях строго запрещено.

### Аппаратные разработки

- Аппаратные разработки OpenBot предназначены для обучения и экспериментов и могут подходить не для всех вариантов применения.
- Пользователи самостоятельно отвечают за соответствие собранного оборудования OpenBot стандартам безопасности и нормативным требованиям, применимым в их регионе.
- Участники и сопровождающие проекта OpenBot не несут ответственности за травмы, ущерб или потери, возникшие в результате сборки, изменения конструкции или эксплуатации роботов на основе аппаратных разработок OpenBot.
- При сборке и эксплуатации роботов на основе OpenBot пользователям следует соблюдать осторожность и уделять первоочередное внимание безопасности.

### Общие положения

- Участники и сопровождающие проекта OpenBot отказываются от ответственности за ущерб или потери, прямо или косвенно связанные с использованием либо ненадлежащим использованием программного обеспечения и аппаратных разработок OpenBot.
- Пользователям рекомендуется применять материалы OpenBot ответственно, этично и с соблюдением всех применимых законов и нормативных требований.

Используя программное обеспечение и аппаратные разработки OpenBot, вы подтверждаете, что прочитали и поняли этот отказ от ответственности и согласны с его условиями.
