nitrobin/OpenBot/DISCLAIMER.zh-CN.md

## 免责声明

<p align="center">
  <a href="DISCLAIMER.ru-RU.md">Русский</a> |
  <a href="DISCLAIMER.md">English</a> |
  <span>简体中文</span> |
  <a href="DISCLAIMER.de-DE.md">Deutsch</a> |
  <a href="DISCLAIMER.fr-FR.md">Français</a> |
  <a href="DISCLAIMER.es-ES.md">Español</a> |
  <a href="DISCLAIMER.ko-KR.md">한국어</a>
</p>

OpenBot 项目是一个开源计划，旨在为教育、实验和娱乐目的提供可访问的机器人解决方案。以下免责声明概述了 OpenBot 软件和硬件设计的使用条款和条件。

### 软件免责声明

- OpenBot 软件按“原样”提供，不提供任何明示或暗示的保证。
- OpenBot 项目的贡献者和维护者不对使用该软件可能导致的任何损坏或数据丢失负责。
- 用户有责任确保其使用 OpenBot 软件符合所有相关法律和法规。
- 严禁将软件用于恶意或不道德的目的。

### 硬件免责声明

- OpenBot 硬件设计仅供教育和实验用途，可能不适用于所有使用场景。
- 用户有责任确保其实施的 OpenBot 硬件符合其所在地区适用的安全标准和法规。
- OpenBot 项目的贡献者和维护者不对基于 OpenBot 硬件设计的机器人在构建、修改或操作过程中导致的任何伤害、损坏或损失负责。
- 用户在构建和操作基于 OpenBot 的机器人时应谨慎行事，并优先考虑安全。

### 一般免责声明

- OpenBot 项目的贡献者和维护者对因直接或间接使用或误用 OpenBot 软件和硬件设计而导致的任何损害或损失不承担任何责任。
- 鼓励用户负责任地、道德地使用 OpenBot 资源，并遵守所有适用的法律和法规。

通过使用 OpenBot 软件和硬件设计，您确认您已阅读、理解并同意本免责声明的条款。
