nitrobin/OpenBot/body/diy/fritzing/openbot-diy-power-hub-schematic.png

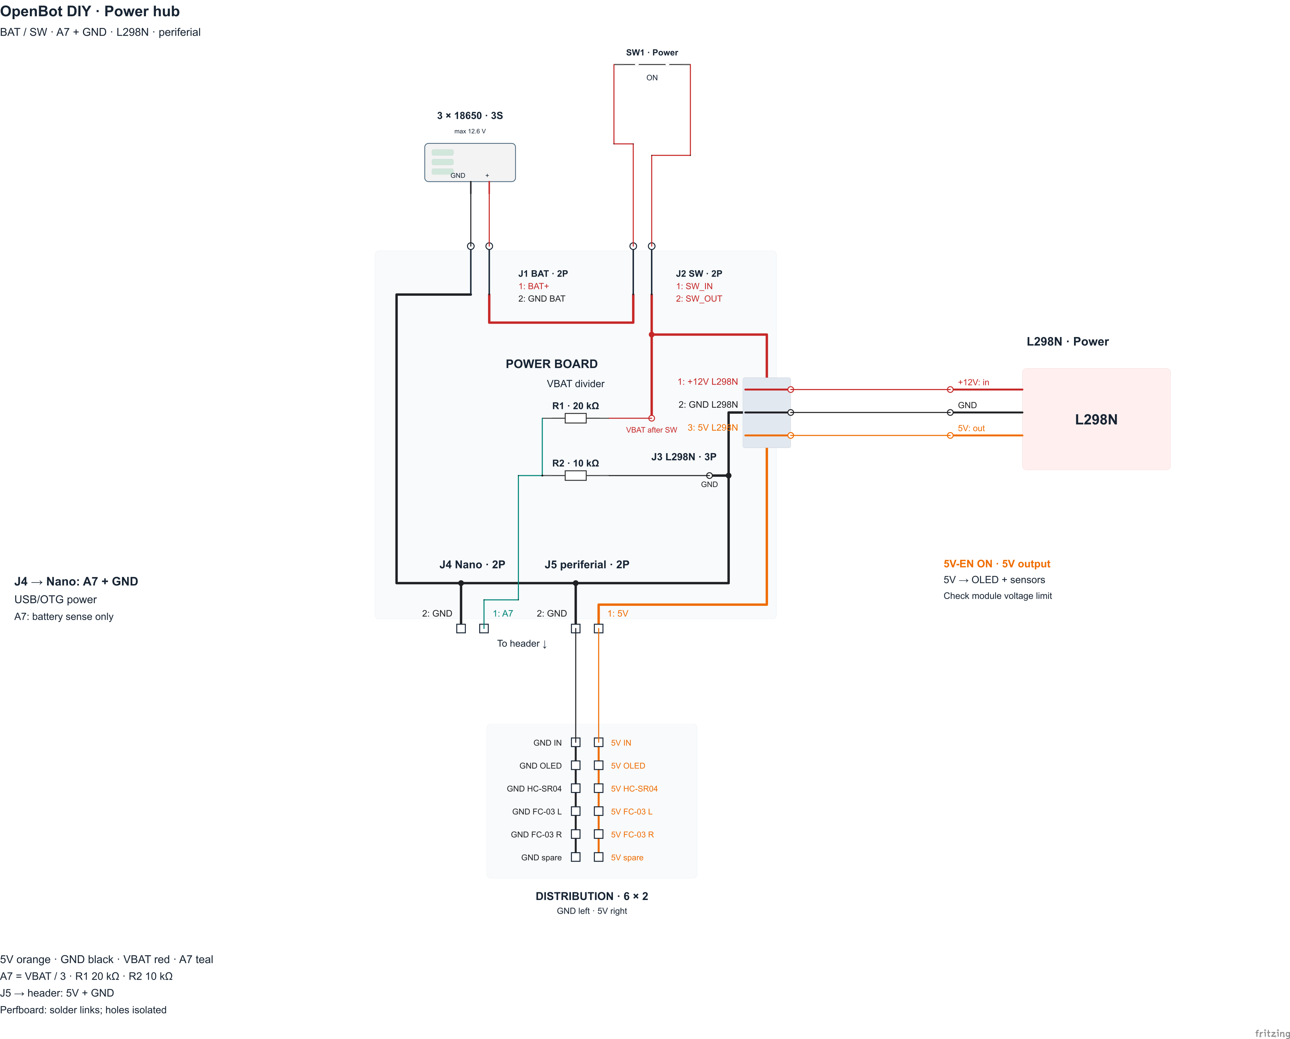
body/diy/fritzing/openbot-diy-power-hub-schematic.png
