nitrobin/OpenBot/(list of files, drawings)

Other design files:
body/diy/fritzing/openbot-diy-esp32-breadboard.fzz
body/diy/fritzing/openbot-diy-esp32.fzz
body/diy/fritzing/openbot-diy-nano-breadboard.fzz
body/diy/fritzing/openbot-diy-nano-on-breadboard.fzz
body/diy/fritzing/openbot-diy-nano.fzz
body/diy/fritzing/openbot-diy-power-hub.fzz
body/diy/fritzing/source-breadboard-esp32/openbot-diy-esp32-breadboard.fz
body/diy/fritzing/source-breadboard-nano/openbot-diy-nano-breadboard.fz
body/diy/fritzing/source-esp32/openbot-diy-esp32.fz
body/diy/fritzing/source-nano-on-breadboard/openbot-diy-nano-on-breadboard.fz
body/diy/fritzing/source/openbot-diy-nano.fz
