nitrobin/OpenBot/(commit log)

2026-10-10 Add Russian DIY assembly documentation and engineering glossary
2026-10-10 Clarify pin labels and beginner terminology in Russian glossary
2026-10-11 Add editable Nano and ESP32 wiring diagrams
2026-10-11 Use Fritzing library parts and add power distribution variants
    Add a Nano solderless breadboard layout with mounted resistors and LEDs. Preserve Nano and ESP32 connectivity against the saved baseline in both Fritzing views, with an independent validator and report.
2026-10-11 Add detachable Nano power hub and clean Fritzing artifacts
2026-10-13 Separate power distribution board and center divider resistors
2026-10-14 Localize power hub labels and export Breadboard SVGs
2026-10-14 Move Nano connector below board and rotate battery holder
